xiaolongsya/x3-stm32-robot-dog/旭日X3 40pin引脚表.png

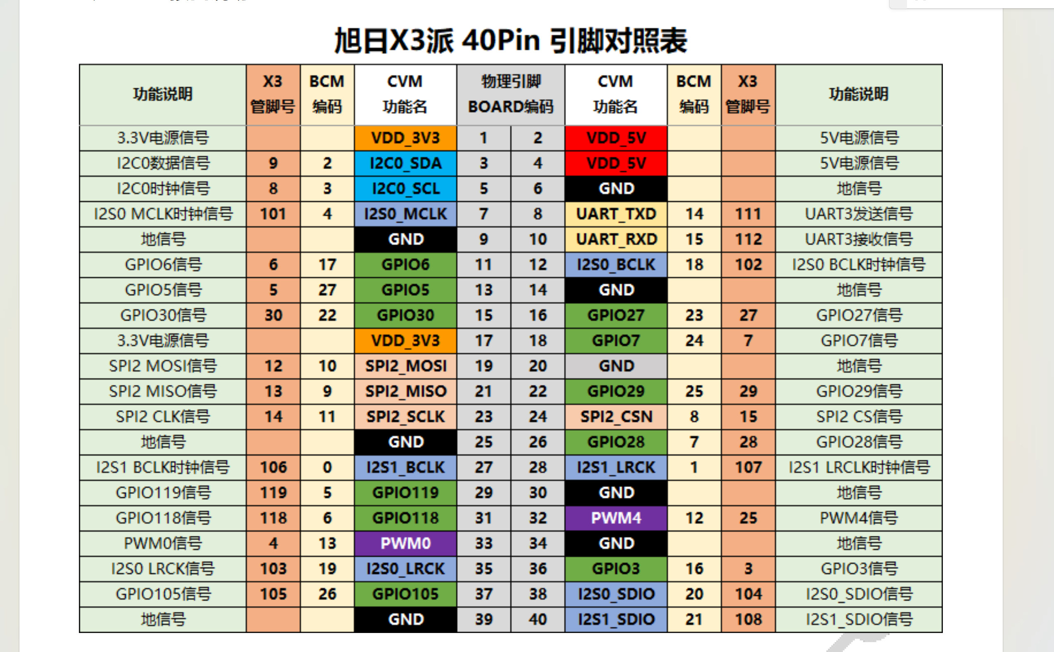
旭日X3 40pin引脚表.png
