xiaolongsya/x3-stm32-robot-dog/BOM采购清单_对照库存.md

# 机器狗 v1 BOM 采购清单(对照元器件库存)

> **生成日期**:2026-09-02 22:30
> **对照基准**:`c:/Users/17402/Desktop/元器件库存.md`(2026-08-24)
> **说明**:对照后逐行核对,有库存 = ✓,无库存 = ✗,有但封装/型号不匹配 = ⚠️
>
> **采购优先级**:
> - ✗ 必须买(库存没有,机器狗 v1 PCB 需要)
> - ⚠️ 建议买(库存有但封装/型号不匹配,勉强可代)
> - ✓ 不用买(库存有同型号,直接用)

---

## 一、电阻

| # | Designator | 值 | 封装 | 库存? | 备注 |
|---|---|---|---|---|---|
| 1 | R1 | 10kΩ | 0603 | ✓ | 库存 FRC0603J103 ×100 |
| 2 | R2 | 10kΩ | 0603 | ✓ | 同上 |
| 3 | R3 | 1kΩ | 0603 | ✓ | 库存 FRC0603F1001TS ×100 |
| 4 | R5 | 1kΩ | 0603 | ✓ | 同上 |
| 5 | R10 | 4.7kΩ | 0603 | ✓ | 库存 FRC0603F4701TS ×100(C1 修复后改 4.7kΩ) |
| 6 | R11 | 4.7kΩ | 0603 | ✓ | 同上 |
| 7 | R13 | 10kΩ | 0805 | ✓ | 库存 FRC0805F1002TS ×100 |
| 8 | R15 | 200kΩ | 0603 | ✗ | **库存没有**,必须新买(C2907009) |
| 9 | R16 | 100kΩ | 0603 | ✓ | 库存 FRC0603F1003TS ×100 |

---

## 二、电容

| # | Designator | 值 | 耐压 | 封装 | 库存? | 备注 |
|---|---|---|---|---|---|---|
| 10 | C1 | 100nF | 50V | C0603 | ✓ | 库存 FCC0603B104K500CT ×50 |
| 11 | C2 | 100nF | 50V | C0603 | ✓ | 同上 |
| 12 | C3 | 22µF(陶瓷)| 16V | C0603 | ⚠️ | **库存只有 0805 22µF,封装不匹配,建议买 0603** |
| 13 | C4 | 22µF(陶瓷)| 16V | C0603 | ⚠️ | 同上 |
| 14 | C6 | 100nF | 50V | C0603 | ✓ | 同 C1 |
| 15 | C7 | 100nF | 50V | C0603 | ✓ | 同 C1 |
| 16 | C9 | 100nF | 50V | C0603 | ✓ | 同 C1 |
| 17 | C10 | 22µF(铝电解)| 16V | SMD 4×4.3 | ✓ | 库存 JVJ16V22M4X5 ×20 |
| 18 | C11 | 100nF | 50V | C0603 | ✓ | 同 C1 |
| 19 | C12 | 100nF | 50V | C0603 | ✓ | 同 C1 |
| 20 | C13 | 10nF | 50V | C0603 | ✗ | **库存没有**,必须新买(C5137477) |
| 21 | C14 | 100nF | 50V | C0603 | ✓ | 同 C1 |
| 22 | C15 | 100nF | 50V | C0603 | ✓ | 同 C1 |
| 23 | C16 | 100nF | 50V | C0603 | ✓ | 同 C1 |
| 24 | C18 | 100nF | 50V | C0603 | ✓ | 同 C1 |
| 25 | C19 | 470µF(铝电解)| 35V | SMD 10×10.3 | ⚠️ | **库存只有 12.5×13.6 470µF,尺寸略大**,建议买 10×10 |
| 26 | C20 | 220µF(铝电解)| 25V | SMD 6.3×6.6 | ⚠️ | **库存只有 10×10.3 220µF,尺寸偏大**,建议买 6.3×6.6 |
| 27 | C21 | 220µF(铝电解)| 25V | SMD 6.3×6.6 | ⚠️ | 同 C20 |
| 28 | C22 | 22pF | 50V | C0603 | ✗ | **库存没有 22pF 0603**(只有 0402 100pF),必须新买(C1653) |
| 29 | C23 | 22pF | 50V | C0603 | ✗ | 同上 |

---

## 三、二极管 / 保险丝

| # | Designator | 型号 | 封装 | 库存? | 备注 |
|---|---|---|---|---|---|
| 30 | D1 | SS54(5A/40V 肖特基)| SMA 贴片 | ⚠️ | **库存只有 1N5825 DO-201AD(插件),封装不同,不可代,必买 SS54** |
| 31 | D2 | SS54(5A/40V 肖特基)| SMA 贴片 | ⚠️ | 同上 |
| 32 | F1 | SMD2920-500-24(5A/24V 自恢复)| F2920 | ✓ | 库存 R+O C47753903 ×5 |

---

## 四、电感

| # | Designator | 值 | 封装 | 库存? | 备注 |
|---|---|---|---|---|---|
| 33 | L1 | 33µH ≥5A Isat | GSM1040(11.5×10.5)| ✓ | 库存 FAUKU GSM1040-330-M ×5 |
| 34 | L2 | 33µH ≥5A Isat | GSM1040(11.5×10.5)| ✓ | 同上 |

---

## 五、IC(芯片)

| # | Designator | 型号 | 封装 | 库存? | 备注 |
|---|---|---|---|---|---|
| 35 | U1 | STM32G431KBT6TR | LQFP-32(7×7)| ✗ | **库存没有 STM32G431 系列,必须新买**(C5270317,¥15) |
| 36 | U2 | LM2596S-5.0(固定 5V 版)| TO-263-5 | ⚠️ | **库存只有 1 个 LM2596S-5.0,机器狗需要 2 个,再买 1 个**(C2980820) |
| 37 | U10 | LM2596S-5.0(固定 5V 版)| TO-263-5 | ⚠️ | 同上(库存 1 个用完,需再买 1 个) |
| 38 | U9 | AMS1117-3.3(固定 3.3V 版)| SOT-223-4 | ✗ | **库存没有 AMS1117,必须新买**(C369933) |

---

## 六、晶体 / 振荡器

| # | Designator | 型号 | 封装 | 库存? | 备注 |
|---|---|---|---|---|---|
| 39 | X1 | 8MHz 贴片 | SMD 3225(3.2×2.5)| ✗ | **库存没有贴片晶振,必须新买**(YXC X32258MSB4SI, C2682774) |

---

## 七、晶体管 / 三极管

| # | Designator | 型号 | 封装 | 库存? | 备注 |
|---|---|---|---|---|---|
| 40 | Q1 | SS8050(NPN, β≥100, Vceo=25V)| SOT-23-3 | ✗ | **库存没有 SS8050**(只有 AO3401A P-MOS),必须新买(C7420370) |

---

## 八、LED

| # | Designator | 型号 | 封装 | 库存? | 备注 |
|---|---|---|---|---|---|
| 41 | LED1 | GL0805UR01(红)| 0805 | ✓ | 库存 XL-2012SURC 0805 红 LED ×100(可代,亮度可能略低) |

---

## 九、按键 / 开关

| # | Designator | 型号 | 封装 | 库存? | 备注 |
|---|---|---|---|---|---|
| 42 | KEY1 | TS-1045AD-A8B3-D2 | SMD 4-pin | ✗ | **库存没有触摸开关,必须新买**(C2894745,LCSC 标 YUANDI) |
| 43 | RESET1 | TS-1045AD-A8B3-D2 | SMD 4-pin | ✗ | 同上 |
| 44 | SW1 | HX KCD11-2P-R(船型开关)| THT | ✗ | **库存没有船型开关,必须新买**(C6917318) |

---

## 十、蜂鸣器

| # | Designator | 型号 | 封装 | 库存? | 备注 |
|---|---|---|---|---|---|
| 45 | BUZZER1 | ~~2.7kHz 电磁蜂鸣器~~ | BUZ-TH_BD9.0 | ✗ (~~不装~~) | **2026-09-16 链路作废,不采购**(原:C96256,QMB-09B-03) |

---

## 十一、连接器 / 排针

| # | Designator | 型号 | 封装 | 库存? | 备注 |
|---|---|---|---|---|---|
| 46 | CN1 | XT30PW-M 母座(电池)| THT | ✗ | **库存没有 XT30,必须新买**(C431092,AMASS) |
| 47 | Pi | HX 2.54mm-2P ZZ-MS(XH2.54 2P 母座)| THT | ✓ | 库存 XH2.54 2P 母座 |
| 48 | HC-SR04 | LAIL-PHC2.54-4P-01-XH-L | THT 4P | ✓ | 库存 XH2.54 4P 母座 ×20 |
| 49 | OLED | LAIL-PHC2.54-4P-01-XH-L | THT 4P | ✓ | 同上 |
| 50 | H5 | 01.5.5.1.304.03(12P 排针)| HDR-TH_12P-2.54 | ⚠️ | 库存有 2.54 通用排针,可代用(剪 12P) |
| 51 | H6 | 01.5.5.1.304.03(12P 排针)| HDR-TH_12P-2.54 | ⚠️ | 同上 |
| 52 | J1 | 2.54-1×10P 直立排针 | HDR-TH_10P-2.54 | ✓ | 库存 BOOMELE 1×10P |
| 53 | J2 | 2.54-1×10P 直立排针 | HDR-TH_10P-2.54 | ✓ | 同上 |
| 54 | MPU6050 | 2.54-1×8 直立排针 | HDR-TH_8P-2.54 | ⚠️ | 库存有 2.54 通用排针,可代用(剪 8P) |

---

## 十二、测试点

| # | Designator | 型号 | 封装 | 库存? | 备注 |
|---|---|---|---|---|---|
| 55 | TP1 | Test-Point | Test-Point-0.5mm | ✗ | **库存没有测试点,必须新买** |
| 56 | TP2 | Test-Point | Test-Point-0.5mm | ✗ | 同上 |

---

## 十三、外部模块(非 PCB 板载元件)

| # | 模块 | 库存? | 备注 |
|---|---|---|---|
| 57 | MPU6050 GY-521 模块 | ✗ | 淘宝/嘉立创 ~¥5 |
| 58 | SSD1306 OLED 0.96" I2C | ✗ | 淘宝 ~¥5 |
| 59 | HC-SR04 超声波测距(新版免分压) | ✗ | 淘宝 ~¥3 |
| 60 | MG90S 舵机 ×8 | ✗ | 淘宝 ~¥10×8 = ¥80(大头) |
| 61 | 香橙派 Zero3 | ✗ | 淘宝 ~¥100 |
| 62 | 2S 18650 6800mAh 电池组(蓝火新能源)| ✗ | 淘宝 ~¥80 |

---

## 十四、机械件

| # | Designator | 型号 | 库存? | 备注 |
|---|---|---|---|---|
| 63 | M1 | M3 螺丝孔 | ✓ | 库存 M3×5/×10 |
| 64 | M2 | M3 螺丝孔 | ✓ | 同上 |
| 65 | M3 | M3 螺丝孔 | ✓ | 同上 |
| 66 | M4 | M3 螺丝孔 | ✓ | 同上 |

---

## 📊 汇总统计

| 类别 | 数量 |
|---|---|
| ✓ 库存有,直接用 | **20 项** |
| ⚠️ 库存有但需新买(封装/型号不匹配) | **9 项** |
| ✗ 库存没有,必须新买 | **19 项** |
| **总计元件位** | **48 项**(PCB 板载,不含外部模块/电池) |

---

## 🛒 必须新买的清单(19 项,按优先级)

### IC(核心,¥22)
- ✗ **U1 STM32G431KBT6TR ×1** ¥15 (C5270317)
- ⚠️ **U2/U10 LM2596S-5.0 ×2** ¥3 ×2 = ¥6 (C2980820)— 库存有 1 个,再买 1 个
- ✗ **U9 AMS1117-3.3 ×1** ¥0.5 (C369933)

### 元件(¥6)
- ✗ R15 200kΩ 0603 ×1 ¥0.05 (C2907009)
- ✗ C13 10nF 0603 ×1 ¥0.05 (C5137477)
- ✗ C22 C23 22pF 0603 ×2 ¥0.1 (C1653)
- ✗ Q1 SS8050 ×1 ¥0.3 (C7420370)
- ✗ X1 8MHz 3225 ×1 ¥1 (C2682774)
- ⚠️ D1/D2 SS54 SMA ×2 ¥1 ×2 = ¥2 (C7420369)— 库存 1N5825 DO-201AD 不可代
- ⚠️ C3/C4 22µF 0603 ×2 ¥0.5 — 库存 0805 不能代
- ⚠️ C19 470µF 10×10 ×1 ¥2 — 库存 12.5×13.6 略大
- ⚠️ C20/C21 220µF 6.3×6.6 ×2 ¥1 — 库存 10×10.3 偏大

### 接口 / 开关 / 蜂鸣器(¥8)
- ✗ CN1 XT30PW-M ×1 ¥2 (C431092)
- ✗ SW1 KCD11-2P-R ×1 ¥2 (C6917318)
- ✗ KEY1/RESET1 TS-1045AD ×2 ¥0.5×2 = ¥1 (C2894745)
- ~~✗ BUZZER1 2.7kHz ×1 ¥1.5 (C96256)~~ — **2026-09-16 作废,不采购**
- ✗ TP1/TP2 ×2 ¥0.5

### 板外大件(¥268,大头)
- ✗ MG90S ×8 ¥80
- ✗ Pi Zero3 ×1 ¥100
- ✗ 2S 18650 电池 ×1 ¥80
- ✗ MPU6050 模块 ×1 ¥5
- ✗ SSD1306 OLED ×1 ¥5
- ✗ HC-SR04 ×1 ¥3

---

## 💰 总预算估算

| 类别 | 估算金额 |
|---|---|
| PCB 板载元件必须新买 | **~¥36** |
| PCB 板载元件建议补买 | **~¥6** |
| 板外模块(舵机/Pi/电池)| **~¥273** |
| **总计** | **~¥315** |

(对比 README 估的 ¥127,**板载元件实际采购可省 ¥91**,但加上 Pi/电池/舵机,实际总成本约 ¥315)

---

## ✅ 不需新买(全部用库存,共 20 项)

| 类别 | 数量 |
|---|---|
| 电阻 R1/R2/R3/R5/R10/R11/R13/R16 | 9 颗 |
| 电容 C1/C2/C6/C7/C9/C10/C11/C12/C14/C15/C16/C18 | 12 颗(都是 100nF 0603 或 22µF SMD) |
| 自恢复保险丝 F1 | 1 |
| 电感 L1/L2 | 2 |
| LED LED1 | 1 |
| Pi 排针/HC-SR04/OLED 母座/J1/J2 | 5 |
| 螺丝 M1-M4 | 4 |

---

**生成完毕,对比你的实际库存,在 ✗ 处标"已有"/"要买"。**
