xiaolongsya/x3-stm32-robot-dog/RDK_X3_2.0_IO_Schematics.pdf

# RDK X3 2.0 40P UART Debug

### J29采用立式插针

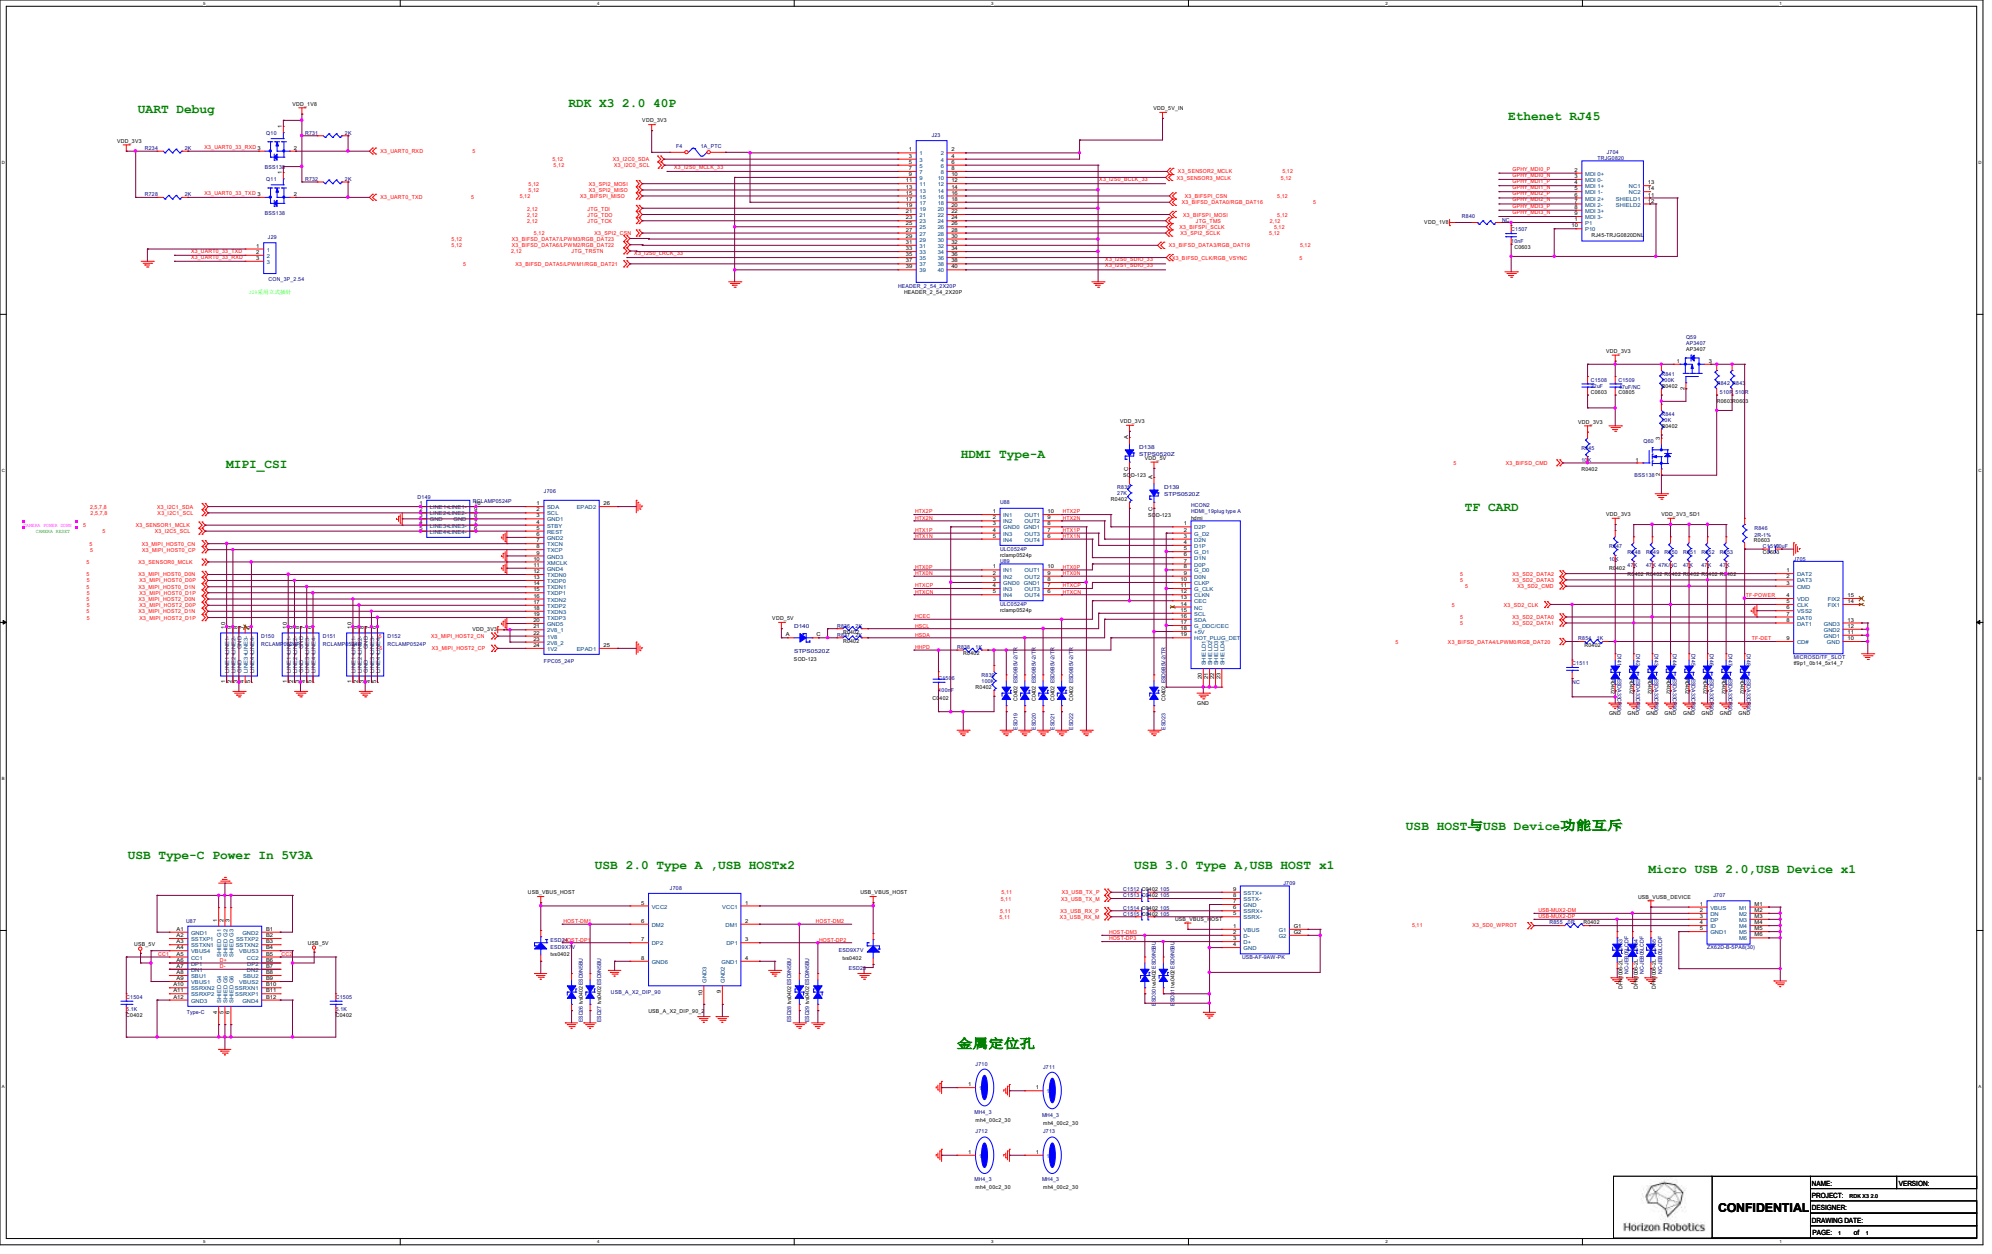
[picture p2: page 1]

R0402 | R0402 | R0402 | R0402 | R0402 | R0402 | DAT3 2

CLK 5 VSS2 6

USB Type-C Power In 5V3A
