xiaolongsya/x3-stm32-robot-dog/STM32项目/MachineDog_V1/Core/Src/main.c

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
/* Includes ------------------------------------------------------------------*/
#include "main.h"
#include "dma.h"
#include "i2c.h"
#include "tim.h"
#include "usart.h"
#include "gpio.h"

/* USER CODE BEGIN Includes */
#include <stdio.h>
#include <string.h>
#include "stepping.h"
#include "motions.h"
#include "commands.h"   /* 2026-09-14 X3 协议入口 */
#include "watchdog.h"   /* 2026-09-14 心跳超时守护 */
#include "diagnostic.h" /* 2026-09-16 上电诊断标记 (从 main.c 搬出, 见 diagnostic.c) */
#include "ramp.h"       /* 2026-09-16 SIT/STAND 渐进 ramp, motion_poll() 自动调 ramp_tick() */
/* USER CODE END Includes */


/* USER CODE BEGIN PV */
/* 8 路舵机 STAND PWM 常量在 main.h(SERVO_*_STAND)
 * 2026-09-11 废弃 gait.c 后,STAND 不再运行时覆盖,改用常量直读
 */
/* USER CODE END PV */

void SystemClock_Config(void);
/* USER CODE BEGIN 0 */
/* 8 路舵机映射表 (servo_id 0-7):
 *  0=PA2=TIM15_CH1=servo0  4=PA6=TIM3_CH1=servo4
 *  1=PA3=TIM15_CH2=servo1  5=PA7=TIM17_CH1=servo5
 *  2=PA4=TIM3_CH2=servo2   6=PB0=TIM3_CH3=servo6
 *  3=PA5=TIM2_CH1=servo3   7=PA8=TIM1_CH1=servo7
 *
 * 腿分布(2026-09-10 用户确认,对称):
 *  前肩: servo3(FR), servo4(FL)
 *  前小腿: servo2(FR), servo5(FL)
 *  后肩: servo1(BR), servo6(BL)
 *  后小腿: servo0(BR), servo7(BL)
 */

/* 当前 8 路舵机 PWM(2026-09-11 移除,cal save 废弃后不需要跟踪) */

/* 非 static:供未来 stepping 模块调用(原型在 main.h)
 * 2026-09-11 移除 current_pwm 跟踪,gait.c 已删,无其他模块需要 */
void set_servo_pulse(uint8_t id, uint16_t pulse) {
  if (pulse < 500 || pulse > 2500) return;
  /* 2026-09-16:同步给 ramp.c 的 g_pwm 跟踪,ramp 起点采样用 */
  motions_track_pwm(id, pulse);
  switch (id) {
    case 0: __HAL_TIM_SET_COMPARE(&htim15, TIM_CHANNEL_1, pulse); break;
    case 1: __HAL_TIM_SET_COMPARE(&htim15, TIM_CHANNEL_2, pulse); break;
    case 2: __HAL_TIM_SET_COMPARE(&htim3, TIM_CHANNEL_2, pulse); break;
    case 3: __HAL_TIM_SET_COMPARE(&htim2, TIM_CHANNEL_1, pulse); break;
    case 4: __HAL_TIM_SET_COMPARE(&htim3, TIM_CHANNEL_1, pulse); break;
    case 5: __HAL_TIM_SET_COMPARE(&htim17, TIM_CHANNEL_1, pulse); break;
    case 6: __HAL_TIM_SET_COMPARE(&htim3, TIM_CHANNEL_3, pulse); break;
    case 7: __HAL_TIM_SET_COMPARE(&htim1, TIM_CHANNEL_1, pulse); break;
  }
}

/* 2026-09-16:蜂鸣器作废(用户拍板),PA11(BUZZER_CTRL 原蜂鸣器驱动脚)
 * 改为输出低,保持静默。硬件(R5 + Q1 SS8050 + D3 + BUZZER1)保留在板上不驱动。
 * 如果未来复用 PA11 为其他 GPIO,可改这里或加新 init。
 */
static void pa11_silent_init(void) {
  __HAL_RCC_GPIOA_CLK_ENABLE();
  GPIO_InitTypeDef gpio = {0};
  gpio.Pin   = GPIO_PIN_11;
  gpio.Mode  = GPIO_MODE_OUTPUT_PP;
  gpio.Pull  = GPIO_NOPULL;
  gpio.Speed = GPIO_SPEED_FREQ_LOW;
  HAL_GPIO_Init(GPIOA, &gpio);
  HAL_GPIO_WritePin(GPIOA, GPIO_PIN_11, GPIO_PIN_RESET);
}

/* 2026-09-14:text 命令解析搬到 commands.c(text 兼容模式),
 * binary 协议也由 commands.c 处理。这里不再有 parse_uart_command / uart_poll。*/
/* USER CODE END 0 */

/**
  * @brief  The application entry point.
  * @retval int
  */
int main(void)
{

  /* MCU Configuration--------------------------------------------------------*/

  /* Reset of all peripherals, Initializes the Flash interface and the Systick. */
  HAL_Init();

  /* Configure the system clock */
  SystemClock_Config();

  /* Initialize all configured peripherals */
  MX_GPIO_Init();
  MX_DMA_Init();
  MX_I2C1_Init();
  MX_TIM2_Init();
  MX_TIM3_Init();
  MX_TIM17_Init();
  MX_USART1_UART_Init();
  MX_TIM15_Init();
  MX_TIM6_Init();
  MX_TIM7_Init();
  MX_TIM1_Init();
  /* USER CODE BEGIN 2 */
  /* ⚠️ 2026-09-12 no-reply 修复:禁用 stdout 缓冲
   * 否则 newlib 可能把 printf 输出缓存在 FILE 里,直到 \n 才 flush,
   * 期间如果进程卡死,数据全丢 */
  setvbuf(stdout, NULL, _IONBF, 0);

  /* 2026-09-16 重构:诊断字符搬到 diagnostic.c(避免 CubeMX Generate Code 丢 })*/


  /* === 2026-09-15 BOOT 标识(诊断 STM32 ↔ X3 链路)===
   * X3 端跑 listen_booted.py 监听 ttyS3,收到 BOOT 说明:
   *   - STM32 跑到了 main()
   *   - USART1 TX 通路正常(PA9 输出)
   * 8 路被强制设"标准值"(跪下姿态,含 FL 肩 +100 / BL 小腿 +80 物理偏移)
   *   = 证明 PWM 输出也正常
   * (2026-09-16:删掉'蜂鸣器响 = 跑到这里'那行,蜂鸣器链路作废)
   */
  /* ⚠️ CubeMX 不自动调 HAL_TIM_PWM_MspPostInit -> 必须手动启动 HAL_TIM_PWM_Start
   * 注意:set_servo_pulse 必须在 HAL_TIM_PWM_Start 之后 */
  HAL_TIM_PWM_Start(&htim1, TIM_CHANNEL_1);    /* PA8  = TIM1_CH1 = servo7 */
  HAL_TIM_PWM_Start(&htim2, TIM_CHANNEL_1);    /* PA5  = TIM2_CH1 = servo3 */
  HAL_TIM_PWM_Start(&htim15, TIM_CHANNEL_1);   /* PA2  = TIM15_CH1 = servo0 */
  HAL_TIM_PWM_Start(&htim15, TIM_CHANNEL_2);   /* PA3  = TIM15_CH2 = servo1 */
  HAL_TIM_PWM_Start(&htim3, TIM_CHANNEL_1);    /* PA6  = TIM3_CH1 = servo4 */
  HAL_TIM_PWM_Start(&htim3, TIM_CHANNEL_2);    /* PA4  = TIM3_CH2 = servo2 */
  HAL_TIM_PWM_Start(&htim3, TIM_CHANNEL_3);    /* PB0  = TIM3_CH3 = servo6 */
  HAL_TIM_PWM_Start(&htim17, TIM_CHANNEL_1);   /* PA7  = TIM17_CH1 = servo5 */

  /* === 上电默认姿态(2026-09-14 整理)===
   * 1) stepping_init() 初始化步态状态机(暂不启 TIM6,等 motion 触发)
   * 2) motion_init() 装载 MOTION_ID + 启动对应动作:
   *    - 先写 8 路 = 标准值/跪下(motion_apply_neutral,含物理偏移)作为安全起点
   *    - 调 current->setup() 跳到对应姿态(STAND / TROT_STAND / SIT)
   *
   * 默认动作(motions.h 的 MOTION_ID = MOTION_STAND):
   *    - 上电跳 STAND 后保持不动,等 X3 命令
   *    - 改 MOTION_ID = MOTION_TROT 才会自动踏步(5s 后启动,30s 结束)
   *
   * 切换其他模式:改 motions.h 的 MOTION_ID
   *    MOTION_STAND    :上电跳 STAND 后保持
   *    MOTION_BOB      :上电跳 STAND,5s 后蹲下,5s 后回 STAND,循环
   *    MOTION_SHIN_TEST:8 路同步线性 ramp 测小腿范围
   */
  stepping_init();
  motion_init();
  /* 2026-09-14:X3 协议 + 心跳守护 */
  commands_init();   /* USART1 DMA + IDLE 启动 */
  watchdog_init();   /* TIM7 1kHz 启动,X3 不发命令 200ms 后自动 STAND */

  /* 上电诊断标记(发 '1' '2' '3' '5' '6' 'B',tabby 看到 = STM32 跑到这步) */
  diagnostic_init();
  /* 2026-09-16:蜂鸣器作废,PA11(BUZZER_CTRL) 输出低保持静默(原 buzzer_init() 替换) */
  pa11_silent_init();
  /* USER CODE END 2 */

  /* Infinite loop */
  /* USER CODE BEGIN WHILE */
  diagnostic_mainloop();  /* 发 'C' = 进 main loop */
  while (1)
  {
    /* USER CODE END WHILE */

    /* USER CODE BEGIN 3 */
    /* === 主循环(2026-09-14:X3 上线后)===
     * 1) motion_poll():推进动作状态机
     * 2) commands_poll():解析 USART1 DMA + IDLE 收到的二进制 / 文本帧
     * 注:watchdog 由 TIM7 1kHz ISR 驱动,不需要在主循环调
     */
    motion_poll();
    commands_poll();
  /* USER CODE END 3 */
  }
}

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
