xiaolongsya/x3-stm32-robot-dog/STM32项目/MachineDog_V1/Core/Inc/main.h

#define SERVO_SHOULDER_FL_STAND   2000  /* 左前肩:PA6/TIM3_CH1/servo4  ↑身体高 / ↓身体低 */
#define SERVO_SHIN_FL_STAND       1400  /* 左前小腿:PA7/TIM17_CH1/servo5 ↑身体高 / ↓身体低 */
#define SERVO_SHOULDER_FR_STAND   1100  /* 右前肩:PA5/TIM2_CH1/servo3  ↑身体高 / ↓身体低 */
#define SERVO_SHIN_FR_STAND       1600  /* 右前小腿:PA4/TIM3_CH2/servo2 ↑身体高 / ↓身体低 */
#define SERVO_SHOULDER_BL_STAND   1900  /* 左后肩:PB0/TIM3_CH3/servo6  ↑身体高 / ↓身体低 */
#define SERVO_SHIN_BL_STAND       1480  /* 左后小腿:PA8/TIM1_CH1/servo7 ↑身体高 / ↓身体低 */
#define SERVO_SHOULDER_BR_STAND   1100  /* 右后肩:PA3/TIM15_CH2/servo1  ↑身体高 / ↓身体低 */
#define SERVO_SHIN_BR_STAND       1600  /* 右后小腿:PA2/TIM15_CH1/servo0 ↑身体高 / ↓身体低 */
#define SERVO_NEUTRAL_US           1500
#define SERVO_OFFSET_FL_SHOULDER   100
#define SERVO_OFFSET_BL_SHIN        80
#define SERVO_NEUTRAL_FL_SHOULDER  (SERVO_NEUTRAL_US + SERVO_OFFSET_FL_SHOULDER)  /* 1600 */
#define SERVO_NEUTRAL_BL_SHIN      (SERVO_NEUTRAL_US + SERVO_OFFSET_BL_SHIN)      /* 1580 */
