xiaolongsya/x3-stm32-robot-dog/X3端/kws/kws_record_send.py

#!/usr/bin/env python3
"""kws_record_send.py — X3 端 KWS 唤醒 → VAD 录音 → WS 上传 PC brain → STM32 执行

⚠️ 2026-09-16 DEPRECATED: 单进程架构存在 oww stateful buffer 二次唤醒根因
   (commit 84ec2ac + 8fd5d1c 打补丁只是治标)。
   已替换为双进程架构: kws_listener.py + kws_worker.py + start_kws_dual.sh
   本文件保留作 fallback,不删除;新部署请用 start_kws_dual.sh。

2026-09-16:生产链路打通版本。

链路:
    arecord (16k mono S16_LE)
       ↓
    KWS 推理 (xiaolong.onnx, 80ms 一段)
       ↓ 唤醒(score > threshold)
    VAD 录音 (累计静音 1.5s 或最大 8s)
       ↓
    base64 PCM → WS 长连 PC brain (ws://<本机IP>:8765)
       ↓
    等 {type: action, actions: [...]} 响应
       ↓
    翻译成 STM32 UART 帧 + 发 /dev/ttyS3@115200

后台:
- STM32 心跳 100ms 一发(防 watchdog 200ms 超时回 STAND)
- WS 断线指数退避 1s/2s/4s/8s/最大 8s

用法:
    /root/kws/kws_record_send.py --pc-url  ws://192.168.160.91:8765

依赖:openwakeword / onnxruntime / pyserial / websockets / numpy
"""
import argparse
import asyncio
import base64
import json
import os
import struct
import sys
import threading
import time

import numpy as np
import serial

DEFAULT_MODEL  = "/root/kws/xiaolong.onnx"
DEFAULT_PORT   = "/dev/ttyS3"
DEFAULT_BAUD   = 115200
DEFAULT_PC_URL = "ws://192.168.160.91:8765"
DEFAULT_THRESH = 0.85
CHUNK = 1280           # 80ms @ 16kHz
MAX_SILENCE_CHUNKS = 18    # 80ms × 18 = 1.44s 静音
MAX_RECORD_CHUNKS  = 100   # 80ms × 100 = 8s 最大


def csum8(data: bytes) -> int:
    c = 0
    for b in data:
        c ^= b
    return c & 0xFF


def send_frame(ser: serial.Serial, cmd: int, payload: bytes = b"") -> None:
    body = bytes([len(payload), cmd]) + payload
    ser.write(b"\xaa\x55" + body + bytes([csum8(body)]))
    ser.flush()


def action_to_stm32_frame(action: dict) -> bytes | None:
    """LLM 输出 action → STM32 UART 帧"""
    cmd_name = action.get("cmd")
    if cmd_name == "ACTION_PLAY":
        action_id = action.get("id")
        if action_id not in (5, 6, 7, 8):
            return None
        return send_frame_bytes(0x09, bytes([action_id, 1]))
    elif cmd_name == "MOTION_PLAY":
        motion_id = action.get("id")
        dur_ms = int(action.get("duration_ms", 5000))
        if motion_id not in (1, 2, 3, 4):
            return None
        payload = bytes([motion_id]) + struct.pack("<I", dur_ms)
        return send_frame_bytes(0x01, payload)
    elif cmd_name == "EMERGENCY_STOP":
        return send_frame_bytes(0x06, b"")
    return None


def send_frame_bytes(cmd: int, payload: bytes) -> bytes:
    body = bytes([len(payload), cmd]) + payload
    return b"\xaa\x55" + body + bytes([csum8(body)])


def compute_rms(pcm_bytes: bytes) -> int:
    """计算帧 RMS,用于静音检测"""
    samples = np.frombuffer(pcm_bytes, dtype=np.int16)
    if len(samples) == 0:
        return 0
    return int(np.sqrt(np.mean(samples.astype(float) ** 2)))


SILENCE_RMS_THRESHOLD = 500   # 帧 RMS < 500 视为静音(VAD 终止条件)
RMS_KWS_LOW = 100               # KWS 评分前 RMS 下限(< 此值 = 没人说话,跳过)
RMS_KWS_HIGH = 3500             # KWS 评分前 RMS 上限(> 此值 = 狗机械声/拍桌/噪声,跳过)


class X3KWSBrainLink:
    """X3 端:KWS + VAD 录音 + WS 上传 + STM32 翻译"""

    # 状态机:
    # "kws"       - KWS 评分监听中
    # "recording" - VAD 录音中(刚唤醒)
    # "busy"      - WS 上传 + STM32 执行中(屏蔽 KWS,防止回声触发)
    # cooldown 默认 10s(KWS 唤醒冷却,防回声短窗触发)

    def __init__(self, model_path, port, baud, pc_url, threshold, cooldown):
        self.threshold = threshold
        self.cooldown = cooldown
        self.pc_url = pc_url
        self.last_wake_ts = 0.0
        self.mode = "kws"

        # STM32 串口
        self.ser = serial.Serial(port, baud, timeout=0.5)
        # 心跳守护
        self.hb_stop = threading.Event()
        threading.Thread(target=self._heartbeat, daemon=True).start()

        # KWS 模型
        from openwakeword.model import Model
        self.oww = Model(wakeword_models=[model_path], inference_framework="onnx")
        print(f"[kws] 模型: {model_path}, 阈值: {threshold}")

        # 状态
        self.mode = "kws"            # "kws" / "recording"
        self.record_buffer = []       # 录音缓冲(list of bytes)
        self.silence_chunks = 0

    def _heartbeat(self):
        while not self.hb_stop.is_set():
            send_frame(self.ser, 0x05)
            self.hb_stop.wait(0.1)

    def process_chunk(self, chunk: bytes) -> bytes | None:
        """处理一帧 80ms PCM。返回非 None 表示录音完成。"""
        # busy 状态:录音 + WS + STM32 期间完全不评分
        if self.mode == "busy":
            return None

        if self.mode == "kws":
            # 唤醒冷却:距离上次唤醒 < cooldown,不评分
            now = time.time()
            if now - self.last_wake_ts < self.cooldown:
                return None
            # RMS 预筛:狗机械声 RMS 很高(>3500),人说话 RMS 中等(100-3500)
            # 跳过纯静音(<100)和疑似机械噪声(>3500),只让中间区间评分
            rms = compute_rms(chunk)
            if rms < RMS_KWS_LOW or rms > RMS_KWS_HIGH:
                return None
            pcm = np.frombuffer(chunk, dtype=np.int16)
            preds = self.oww.predict(pcm)
            if not preds:
                return None
            key = next(iter(preds.keys()))
            s = preds[key]
            try:
                score = float(s[-1] if isinstance(s, (np.ndarray, list)) else s)
            except (TypeError, IndexError):
                return None
            if score >= self.threshold:
                print(f"[kws] 🌟 唤醒 score={score:.3f} rms={rms} → 开始录音")
                self.mode = "recording"
                self.record_buffer = [chunk]
                self.silence_chunks = 0
                self.last_wake_ts = now
            return None
        else:
            # recording 模式
            self.record_buffer.append(chunk)
            rms = compute_rms(chunk)
            if rms < SILENCE_RMS_THRESHOLD:
                self.silence_chunks += 1
            else:
                self.silence_chunks = 0
            if self.silence_chunks >= MAX_SILENCE_CHUNKS:
                pcm = self._finish_recording()
                return pcm
            if len(self.record_buffer) >= MAX_RECORD_CHUNKS:
                pcm = self._finish_recording()
                return pcm
            return None

    def set_busy(self, busy: bool):
        """录音完成 → WS 上传 → STM32 执行期间设为 busy,屏蔽 KWS"""
        self.mode = "busy" if busy else "kws"
        if busy:
            self.last_wake_ts = time.time()  # busy 期内也算冷却起点
        print(f"[kws] 模式: {self.mode}")

    def _finish_recording(self):
        pcm = b"".join(self.record_buffer)
        print(f"[rec] 录音完成 {len(pcm)} bytes ({len(pcm)/32000:.2f}s)")
        self.record_buffer = []
        # 关键:这里设 "busy" 而不是 "kws",防止主循环拿到 pcm 之前的窗口期
        # KWS 误判录音期间的 chunk(set_busy 在主循环里调用,有 race condition)
        self.mode = "busy"
        self.silence_chunks = 0
        return pcm

    async def send_to_brain(self, pcm: bytes) -> dict | None:
        """WS 上传 PC brain,等 action 响应。返回 actions 列表或 None"""
        import websockets
        ws_id = "x3_local"
        try:
            async with websockets.connect(self.pc_url) as ws:
                print(f"[ws] 已连接 {self.pc_url}")
                # 发 utterance
                await ws.send(json.dumps({
                    "type": "utterance",
                    "pcm": base64.b64encode(pcm).decode(),
                    "session_id": ws_id,
                }))
                print(f"[ws] → utterance ({len(pcm)} bytes)")
                # 等响应(可能 action 或 error)
                while True:
                    raw = await ws.recv()
                    msg = json.loads(raw)
                    print(f"[ws] ← {msg}")
                    if msg["type"] in ("action", "error"):
                        return msg
        except Exception as e:
            print(f"[ws] 错误: {e}")
            return None

    def translate_and_send_actions(self, actions: list):
        """翻译 actions 为 STM32 帧并发送"""
        for a in actions:
            frame = action_to_stm32_frame(a)
            if frame:
                self.ser.write(frame)
                self.ser.flush()
                print(f"[stm32] → {a['cmd']} #{a.get('id','')}"
                      + (f" dur={a.get('duration_ms')}ms" if 'duration_ms' in a else ""))
            else:
                print(f"[stm32] 跳过非法: {a}")

    def close(self):
        self.hb_stop.set()
        self.ser.close()


async def websockets_connect(url):
    import websockets
    return websockets.connect(url)


async def stdin_reader(queue: asyncio.Queue):
    """后台线程:读 arecord stdin(80ms 一段)→ 放入 asyncio.Queue"""
    loop = asyncio.get_event_loop()

    def _read():
        while True:
            chunk = sys.stdin.buffer.read(CHUNK * 2)
            if not chunk:
                break
            asyncio.run_coroutine_threadsafe(queue.put(chunk), loop)
    t = threading.Thread(target=_read, daemon=True)
    t.start()


async def run(args):
    link = X3KWSBrainLink(
        model_path=args.model,
        port=args.port,
        baud=args.baud,
        pc_url=args.pc_url,
        threshold=args.threshold,
        cooldown=args.cooldown,
    )

    queue: asyncio.Queue = asyncio.Queue()
    await stdin_reader(queue)

    print(f"[kws] 启动,PC brain @ {args.pc_url}")
    print(f"[kws] 唤醒冷却 {args.cooldown}s(冷却期内不评分,避免回声触发)")
    print("[kws] 监听中 —— 说 '小龙' 触发整句录音 → WS 上传 → STM32 执行")
    print("=" * 70, flush=True)

    try:
        while True:
            chunk = await queue.get()
            pcm = await asyncio.to_thread(link.process_chunk, chunk)
            if pcm:
                # 录音完毕 → busy 状态(屏蔽 KWS,防回声)
                await asyncio.to_thread(link.set_busy, True)
                # 误唤醒判断:录音时长 < 2s = VAD 静音提前结束 = 没人说话
                # (用户正常说话至少 2-3s,太短说明 KWS 误触发了)
                pcm_duration_s = len(pcm) / 32000
                false_wake = pcm_duration_s < 2.0
                try:
                    resp = await link.send_to_brain(pcm)
                    if resp and resp.get("type") == "action":
                        actions = resp.get("actions", [])
                        reply = resp.get("reply", "")
                        print(f"[brain] reply: {reply}")
                        if actions and not false_wake:
                            # 真有动作 + 录音够长:发 STM32
                            await asyncio.to_thread(link.translate_and_send_actions, actions)
                        elif false_wake:
                            # 录音 < 2s 即便 LLM 给动作也不做(可能是误触发)
                            print(f"[brain] 录音仅 {pcm_duration_s:.2f}s,误唤醒跳过动作")
                        else:
                            # actions=空:用户说了话但能力外,当作正常唤醒
                            print("[brain] actions 空(可能超出能力),不当误唤醒")
                    elif resp and resp.get("type") == "error":
                        print(f"[brain] error: {resp.get('code')} {resp.get('reply')}")
                        if resp.get("code") == "ASR_FAIL":
                            false_wake = True  # ASR 失败 = 录音里没人说话 = 误唤醒
                    else:
                        print("[brain] 无响应")
                finally:
                    # 任务完成后 cooldown 强制 sleep 完整配置值(2026-09-16 修复)
                    # 原版条件 sleep `max(0, cooldown - elapsed)` 会被 ASR 首调 SenseVoiceSmall
                    # + Ollama qwen3:8b 首 token 延迟 8-15s 直接吃掉,remaining 算成 0,无 sleep,
                    # set_busy(False) 立即切回 kws,下一个 chunk 进 oww.predict() 命中旧"小龙"
                    # 残音 → 第二次唤醒(commit 84ec2ac 已加 oww buffer reset,这里补一刀)。
                    # 改成无条件 await asyncio.sleep(args.cooldown) 强制睡满配置值。
                    print(f"[kws] 任务完成,强制 cooldown {args.cooldown:.1f}s")
                    await asyncio.sleep(args.cooldown)
                    # 清空 queue 里累积的"陈旧"chunk(录音期间 + cooldown 期内)
                    # 这些 chunk 可能含 dog 动机械声 / 房间回声
                    # 直接丢弃,从 fresh audio 开始
                    drained = 0
                    while not queue.empty():
                        try:
                            queue.get_nowait()
                            drained += 1
                        except asyncio.QueueEmpty:
                            break
                    if drained > 0:
                        print(f"[kws] 清空 queue {drained} 个陈旧 chunk")
                    # === KWS 二次触发根因修复(2026-09-16)===
                    # oww Model 内部维护 6s sliding audio buffer;录音期间 mode=recording/busy
                    # 完全不喂新数据,buffer 冻在"小龙"音频上,set_busy(False) 后下一帧 predict()
                    # 仍会基于旧"小龙"给高分(score 0.97+),用户实测每次喊一次都触发两次唤醒。
                    # 喂 75 × 80ms = 6s 静音把 oww buffer 整体替换成静音,score 降回 0
                    # (cooldown 检查在 process_chunk 里另有一道防线,这里只负责 reset oww 内部状态)
                    zero_pcm = np.zeros(1280, dtype=np.int16)
                    for _ in range(75):
                        link.oww.predict(zero_pcm)
                    print(f"[kws] oww buffer reset 完成 (喂 6s 静音)")
                    await asyncio.to_thread(link.set_busy, False)
    except KeyboardInterrupt:
        print("\n[kws] Bye")
    finally:
        link.close()


def main():
    ap = argparse.ArgumentParser(description="X3 端 KWS + VAD 录音 + WS 上传 PC brain")
    ap.add_argument("--model",    default=DEFAULT_MODEL)
    ap.add_argument("--port",     default=DEFAULT_PORT)
    ap.add_argument("--baud",     type=int, default=DEFAULT_BAUD)
    ap.add_argument("--pc-url",   default=DEFAULT_PC_URL)
    ap.add_argument("--threshold", type=float, default=DEFAULT_THRESH)
    # cooldown 默认 10s:任务完成后固定冷却,防回声/机械声连环触发
    ap.add_argument("--cooldown",  type=float, default=10.0)
    args = ap.parse_args()

    asyncio.run(run(args))


if __name__ == "__main__":
    main()
