xiaolongsya/x3-stm32-robot-dog/scripts/step_debug.py

#!/usr/bin/env python3
"""step_debug.py — 8 路舵机交互式分步调试,H_LIFT 可调 (2026-09-12)

设计目的:
  step trot 不动,通讯 OK(sit/stand 已验证)。
  分步调试:按腿顺序(左前 → 右前 → 左后 → 右后),每条腿先大腿后小腿。

用法:
  python3 step_debug.py [H_LIFT_MM]

H_LIFT_MM:
  - 命令行参数(默认 10)
  - 也可环境变量 H_LIFT 覆盖
  - 决定所有"收腿"步骤的 PWM 偏移(远场近似 1mm ≈ 4µs)

示例:
  python3 step_debug.py            # 默认 H_LIFT=10mm
  python3 step_debug.py 5          # 5mm(原 commit 753e686 默认)
  python3 step_debug.py 20         # 20mm(FR/FL 小腿临界,余量 20µs)

交互:
  [enter]         执行当前预命令 + 自动跳到下一步
  [数字 n]        跳到第 n 步
  [任意文本]      当作 STM32 命令发送(不跳步,可重复测同一动作)
  [q]            退出(自动回 STAND)

预设步骤按"单腿"递进(用户拍板 2026-09-12):
  - 0~1:   起始 / STAND 确认
  - 2~13:  单腿单关节测试(左前 → 右前 → 左后 → 右后,每条腿:大腿 → 小腿 → 回 STAND)
  - 14~25: 单腿全收测试(同腿顺序)
  - 26~29: step trot 实测(用 STM32 固件里的 H_LIFT)

环境变量:
  KWS_UART   串口设备(默认 /dev/ttyS1)
  KWS_BAUD   波特率(默认 115200)
  H_LIFT     抬腿高度 mm(默认 10,命令行参数覆盖)
"""
import os
import sys
import time
import serial

UART_DEV = os.environ.get("KWS_UART", "/dev/ttyS1")
UART_BAUD = int(os.environ.get("KWS_BAUD", "115200"))
H_LIFT_MM = float(sys.argv[1]) if len(sys.argv) > 1 else float(os.environ.get("H_LIFT", "10"))
PWM_PER_MM = 4.0
DS_PWM = H_LIFT_MM * PWM_PER_MM  # 远场近似 1mm ≈ 4µs

# === 8 路舵机表 (2026-09-12 实测,舵机名用中文) ===
# 腿分布(用户拍板):
#   前腿: 左前 FL (肩=id 4, 小腿=id 5)
#         右前 FR (肩=id 3, 小腿=id 2)
#   后腿: 左后 BL (肩=id 6, 小腿=id 7)
#         右后 BR (肩=id 1, 小腿=id 0)
#
# 收腿 = 身体降低方向:
#   - 右腿 (FR/BR): PWM 减 (前后舵机反向安装)
#   - 左腿 (FL/BL): PWM 增
SERVOS = [
    # (id, 中文名,         STAND, is_right, safe_min, safe_max)
    (0, "右后小腿 (BR)",   1600, True,  1400, 1600),
    (1, "右后肩 (BR)",     1150, True,  1000, 2000),
    (2, "右前小腿 (FR)",   1500, True,  1400, 1600),
    (3, "右前肩 (FR)",     1200, True,  1000, 2000),
    (4, "左前肩 (FL)",     1820, False, 1000, 2000),
    (5, "左前小腿 (FL)",   1500, False, 1400, 1600),
    (6, "左后肩 (BL)",     1850, False, 1000, 2000),
    (7, "左后小腿 (BL)",   1400, False, 1400, 1600),
]


def lift_pwm(id):
    """收腿 PWM(收 H_LIFT*4 µs):右腿 -,左腿 +"""
    s = SERVOS[id]
    return int(s[2] - DS_PWM) if s[3] else int(s[2] + DS_PWM)


def make_steps():
    """根据 H_LIFT 生成步骤列表(按腿顺序:左前 → 右前 → 左后 → 右后)"""
    DS = int(DS_PWM)

    # 各舵机 swing 极值
    LF_sh   = SERVOS[4][2] + DS   # 左前肩 1820+DS
    LF_shin = SERVOS[5][2] + DS   # 左前小腿 1500+DS
    RF_sh   = SERVOS[3][2] - DS   # 右前肩 1200-DS
    RF_shin = SERVOS[2][2] - DS   # 右前小腿 1500-DS
    LB_sh   = SERVOS[6][2] + DS   # 左后肩 1850+DS
    LB_shin = SERVOS[7][2] + DS   # 左后小腿 1400+DS
    RB_sh   = SERVOS[1][2] - DS   # 右后肩 1150-DS
    RB_shin = SERVOS[0][2] - DS   # 右后小腿 1600-DS

    return [
        # 0-1: 起始
        ("0. all 1500 (8 路全中位,确认基本通讯)",          'all 1500',  None),
        ("1. stand (8 路 → STAND 实测 PWM)",               'stand',     None),

        # 2-4: 左前 (FL) — 大腿 → 小腿 → 回 STAND
        (f"2. 左前肩 → {LF_sh} (1820+{DS},左腿收腿方向)",      f'4 {LF_sh}',   None),
        (f"3. 左前小腿 → {LF_shin} (1500+{DS},左腿收腿方向)",    f'5 {LF_shin}', None),
        ("4. 回 STAND (左前测试完)",                       'stand',     None),

        # 5-7: 右前 (FR)
        (f"5. 右前肩 → {RF_sh} (1200-{DS},右腿收腿方向)",      f'3 {RF_sh}',   None),
        (f"6. 右前小腿 → {RF_shin} (1500-{DS},右腿收腿方向)",    f'2 {RF_shin}', None),
        ("7. 回 STAND (右前测试完)",                       'stand',     None),

        # 8-10: 左后 (BL)
        (f"8. 左后肩 → {LB_sh} (1850+{DS},左腿收腿方向)",      f'6 {LB_sh}',   None),
        (f"9. 左后小腿 → {LB_shin} (1400+{DS},左腿收腿方向)",    f'7 {LB_shin}', None),
        ("10. 回 STAND (左后测试完)",                      'stand',     None),

        # 11-13: 右后 (BR)
        (f"11. 右后肩 → {RB_sh} (1150-{DS},右腿收腿方向)",     f'1 {RB_sh}',   None),
        (f"12. 右后小腿 → {RB_shin} (1600-{DS},右腿收腿方向)",   f'0 {RB_shin}', None),
        ("13. 回 STAND (右后测试完)",                      'stand',     None),

        # 14-17: 左前 全收测试
        (f"14. 左前肩 收 {DS}",                              f'4 {LF_sh}',   None),
        (f"15. 左前小腿 收 {DS}",                            f'5 {LF_shin}', None),
        ("16. 回 STAND (左前全收测试完)",                   'stand',     None),

        # 17-19: 右前 全收
        (f"17. 右前肩 收 {DS}",                              f'3 {RF_sh}',   None),
        (f"18. 右前小腿 收 {DS}",                            f'2 {RF_shin}', None),
        ("19. 回 STAND (右前全收测试完)",                   'stand',     None),

        # 20-22: 左后 全收
        (f"20. 左后肩 收 {DS}",                              f'6 {LB_sh}',   None),
        (f"21. 左后小腿 收 {DS}",                            f'7 {LB_shin}', None),
        ("22. 回 STAND (左后全收测试完)",                   'stand',     None),

        # 23-25: 右后 全收
        (f"23. 右后肩 收 {DS}",                              f'1 {RB_sh}',   None),
        (f"24. 右后小腿 收 {DS}",                            f'0 {RB_shin}', None),
        ("25. 回 STAND (右后全收测试完)",                   'stand',     None),

        # 26-29: 完整踏步测试(用 STM32 固件 H_LIFT,与脚本参数无关)
        ("26. step trot (启动踏步,STM32 固件 H_LIFT)",   'step trot', None),
        ("27. 等 5 秒 (看机器狗动作)",                     None,        5),
        ("28. step stop",                                  'step stop', None),
        ("29. 最终回 STAND",                               'stand',     None),
    ]


def print_header(steps):
    print("=" * 64, flush=True)
    print(f"8 路舵机交互式分步调试  (2026-09-12)", flush=True)
    print("=" * 64, flush=True)
    print(f"UART: {UART_DEV} @ {UART_BAUD}", flush=True)
    print(f"H_LIFT: {H_LIFT_MM} mm  (PWM 偏移: {DS_PWM:.0f} µs / 关节)", flush=True)
    print(f"背景:step trot 不动 / sit/stand 通讯 OK / 分步定位问题", flush=True)
    print(f"腿顺序:左前 → 右前 → 左后 → 右后 (每条腿:大腿 → 小腿 → 回 STAND)", flush=True)
    print("", flush=True)

    # 打印 SERVO 表
    print("8 路舵机表(中文名):", flush=True)
    print(f"  {'id':<3} {'中文名':<18} {'STAND':<6} {'方向':<8} {'收腿 PWM':<10} {'limit':<12}", flush=True)
    for s in SERVOS:
        id, name, stand, is_right, smin, smax = s
        dir_str = "右腿(PWM-)" if is_right else "左腿(PWM+)"
        lp = lift_pwm(id)
        print(f"  {id:<3} {name:<18} {stand:<6} {dir_str:<10} {lp:<10} ({smin},{smax})", flush=True)
    print("", flush=True)

    # 打印步骤列表
    print(f"预设步骤 ({len(steps)} 步):", flush=True)
    for i, (desc, cmd, sleep_s) in enumerate(steps):
        extra = f" sleep={sleep_s}s" if sleep_s else ""
        cmd_str = f"'{cmd}'" if cmd else "(仅 sleep)"
        print(f"  [{i:>2}] {desc}  → {cmd_str}{extra}", flush=True)
    print("", flush=True)


def main():
    steps = make_steps()
    print_header(steps)

    # 开串口
    try:
        ser = serial.Serial(UART_DEV, UART_BAUD, timeout=0.3)
    except Exception as e:
        print(f"[ERR] 串口打开失败: {e}", flush=True)
        sys.exit(1)
    time.sleep(0.3)
    ser.reset_input_buffer()
    print(f"[test] ✅ 串口已开\n", flush=True)

    cur = 0
    try:
        while True:
            if cur >= len(steps):
                print("\n[test] 所有步骤走完,退出", flush=True)
                break

            desc, cmd, sleep_s = steps[cur]
            prompt = (
                f"\n[{cur:>2}/{len(steps)-1}] {desc}\n"
                f"预命令: {cmd if cmd else '(无)'}, sleep: {sleep_s if sleep_s else 0}s\n"
                f"> [enter] 执行+跳步 | [数字] 跳步 | [文本] 自定义命令(不跳) | [q] 退出: "
            )
            try:
                inp = input(prompt).strip()
            except EOFError:
                print("\n[test] EOF,退出", flush=True)
                break

            if inp.lower() == 'q':
                print("[test] 用户退出", flush=True)
                break

            # 跳步
            if inp.isdigit():
                n = int(inp)
                if 0 <= n < len(steps):
                    cur = n
                    continue
                else:
                    print(f"  [warn] 步骤超出范围 0..{len(steps)-1}", flush=True)
                    continue

            # 自定义命令(覆盖预命令)
            if inp:
                cmd = inp
                sleep_s = None
                tag = "[自定义]"
            else:
                tag = "[预命令]"

            # 执行
            if cmd:
                try:
                    ser.write((cmd + "\n").encode())
                    ser.flush()
                    print(f"  {tag} → UART: '{cmd}'", flush=True)
                except Exception as e:
                    print(f"  [ERR] 串口写失败: {e}", flush=True)
                    break

            if sleep_s:
                print(f"  → sleep {sleep_s}s ...", flush=True)
                time.sleep(sleep_s)

            # enter(空)才跳步,自定义命令不跳步(可重复测)
            if not inp:
                cur += 1

    except KeyboardInterrupt:
        print("\n[test] Ctrl+C 中断", flush=True)

    finally:
        # 回 STAND
        print("\n[test] 回 STAND 收尾...", flush=True)
        try:
            ser.write(b"stand\n")
            ser.flush()
            time.sleep(0.3)
        except Exception:
            pass
        ser.close()
        print("[test] 串口已关, done", flush=True)


if __name__ == "__main__":
    main()
