xiaolongsya/x3-stm32-robot-dog/(commit log)

2026-09-10 8 路舵机标定 + 加 UART 接收 Pi 命令接口
    - 8 个舵机都标定完成(中位 Pulse=1500, 90° → 大腿水平 + 小腿垂直)
    - main.c 加 UART 命令解析(set_servo_pulse + uart_poll)
    - 命令协议: '<servo_id 0-7> <pulse 500-2500>\n' / 'all <pulse>\n' / 'center\n'
    - STM32 回 OK s<N>=<pulse> / OK all=<pulse> / OK center / ERR fmt
    - 加 STM32CubeIDE 工程文件 .cproject / .project 入仓(打开工程用)
    - 8 路舵机映射表(main.c set_servo_pulse):
    0=PA2=TIM2_CH3 / 1=PA3=TIM2_CH4 / 2=PA4=TIM3_CH2 / 3=PA5=TIM2_CH1
    4=PA6=TIM3_CH1 / 5=PA7=TIM17_CH1 / 6=PB0=TIM3_CH3 / 7=PA8=TIM1_CH1
    接 Pi 通信: Pi GPIO14(TXD) → PA10(RX) / Pi GPIO15(RXD) → PA9(TX) / GND-GND
    后续: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
2026-09-10 标定完成进度同步 + 新增运动学参数文档
    README.md:更新到 2026-09-09(标定完成、固件详情、移植待办)
    运动学参数.md:v0.1 初稿,记录小腿舵机几何参数 + 远场近似模型 + 蹲下起立动作设计初稿
2026-09-10 新增 Pi 端舵机 UART 控制脚本 servo_uart.py (pyserial + /dev/ttyS1 115200 8N1)
2026-09-10 运动学参数 v0.2:8 路舵机映射 + 默认姿态 + L_link=60
    - 舵机映射确认:对称分布(前后肩/小腿 + 左右镜像)
    - 前肩:servo3(FR)、servo4(FL);前小腿:servo2(FR)、servo5(FL)
    - 后肩:servo1(BR)、servo6(BL);后小腿:servo0(BR)、servo7(BL)
    - 默认姿态:大腿垂直地面 + 小腿水平向前(X+ 方向)
    - 坐标系:X 向前(头朝向)、Y 向左、Z 向上
    - 几何新增 L_link = 60 mm + 初始连接杆方位(ΔX=18mm, ΔY≈0, ΔZ≈57.24mm)
    - 第 5.5 节新增严格四连杆求解说明(L_link 较短,远场近似误差大,需 Newton 迭代)
    - 用户期望默认姿态"站起来一点":目标身体高度待定
2026-09-10 运动学参数:补测项细化到 X/Y/Z 三分量 + u_s/u_k 含义图示
    - §2.3 d_servo_hip 拆为 X/Y/Z 三分量,补 u_s / u_k 含义说明(单位向量)
    - §7.2 同步更新 TODO 列表
    - 加 ASCII 草图引导用户目视回答舵机偏心点 + 小腿偏心点的初始方向
2026-09-10 运动学参数 v0.3:几何约束明确为 2D(X-Z 平面)
    用户描述舵机几何后,旋转方向和偏心平面已确定:
    - 肩部舵机:转轴 = 大腿方向(±Z),偏心点在水平 X-Y 平面内
    - 小腿舵机:转轴 = 垂直小腿方向(±Y),偏心点在 X-Z 平面内
    降维成果:
    - d_servo_hip.Y 理论为 0,无需测(从 ΔY=0 + u_s/u_k 都无 Y 分量推出)
    - 求解从 3D 降为 2D,旋转统一绕 Y 轴
    - 待测参数从 5 个减为 3 个(d_servo_hip.X/Z + α_s + α_k),任答 2 个可反推第 3 个
    §2.3 / §5.5 / §7.2 同步更新。
2026-09-10 运动学参数 v0.4:α_s 部分已知(A=12.09°),待测参数减为 2 个
    用户描述小腿舵机初始几何:
    - 舵盘和传动杆连接点离舵机中心 x 距离 = 10.5 mm
    - sin A = 10.5 / R_servo = 0.2095 → A = 12.09°(偏心方向与竖直方向夹角)
    - X 分量 = +10.5 mm 已知,Z 分量符号待确认(偏上/偏下)
    d_servo_hip 可从已知几何(ΔX=18, ΔZ=57.24)反推,无需用户测量。
    待测参数从 3 个减为 2 个:
    1. α_s 的 Z 分量符号
    2. α_k(小腿偏心点初始方向角,X-Z 平面内象限)
2026-09-10 v1 进展:STM32 身高控制 + Pi 串口打通
    STM32 端 main.c:
    - 加 apply_height_delta() 函数,4 路小腿舵机同步(servo0/2/5/7)
    - 新 UART 命令 'h <delta_mm>',例: 'h 15' -> 抬升 15 mm
    - 远场近似: 1 mm 身体抬升 ≈ 4 µs PWM 增量(HEIGHT_US_PER_MM,待实测校准)
    - 安全范围: ΔH ∈ [-40, +40] mm, PWM ∈ [500, 2500] µs
    - 保留旧命令 (id, all, center)
    Pi 端串口:
    - /boot/armbianEnv.txt: console=both -> console=display, 移除 overlays=uart5
    - 停 serial-getty@ttyS0.service
    - /dev/ttyS0 现在可被 STM32 独占使用(115200 8N1)
    - pyserial 3.5 已装(系统包)
    - /root/test_stm32_serial.py 测试脚本就绪
    运动学参数.md 同步到 v0.6,记录 STM32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
2026-09-10 fix(stm32):printf 重定向到 USART1(修回执丢失 bug)
    之前 main.c 的 printf('OK center' 等)走 SWO/ITM,不通过 USART1 TX(PA9)发送,
    所以 Pi 端 /dev/ttyS1 收不到任何回执。
    在 usart.c 的 USER CODE BEGIN 1 加 fputc 重定向,所有 printf 输出经 USART1。
    [usart.c]
2026-09-10 fix(stm32):parse 分支顺序 + GPIO 上拉 + printf 短超时(3 个 bug)
    Agent 2 排查发现的 3 个 bug:
    1. parse_uart_command 分支顺序错误:
    - 原 sscanf('%u %u') 遇到 'all' 失败但不消耗输入,导致 'all 1500' 走 else 全失败
    - 修复:用 strncmp('all ', 4) 和 cmd[0]=='h' 前置判别
    - 加 ERR fmt 回显便于调试
    2. USART1 GPIO RX 上拉:
    - 原 Pull = GPIO_NOPULL,RX idle 可能浮空,噪声误触发
    - 修复:GPIO_PULLUP
    3. printf 短超时避免死锁:
    - 原 HAL_MAX_DELAY,TX 短路会无限等,卡住主循环接收
    - 修复:5ms 短超时
    [main.c, usart.c]
2026-09-10 fix(stm32):PA10 RX GPIO 模式 AF_PP -> AF_INPUT(致命 bug)
    症状: 不接 STM32 能看到 Pi TX 数据,接上 STM32 就看不到。
    原因: PA10(RX)被 CubeMX 默认配成 GPIO_MODE_AF_PP(推挽输出),
    STM32 主动驱动 PA10 电平,直接'吃掉'Pi TX 的信号。
    修复:
    - PA9 (TX): 保留 AF_PP(推挽输出,需要驱动信号线)
    - PA10 (RX): 改为 AF_INPUT + GPIO_PULLUP(输入模式,内部上拉防浮空)
    之前所有 PA9+PA10 一起配 AF_PP,导致 RX 引脚输出反向电平,
    Pi 的串口信号被 STM32 短路掉。
    这是端到端通信失败的根因之一。
    [usart.c]
2026-09-10 fix(stm32):GPIO_MODE_AF_INPUT -> GPIO_MODE_INPUT(编译错误)
    STM32G4 HAL 没有 GPIO_MODE_AF_INPUT 枚举值,
    RX 引脚应该用 GPIO_MODE_INPUT + Alternate 复用。
    [usart.c]
2026-09-10 fix(stm32):main() 启动后强制重配 PA10 = INPUT + PULLUP
    CubeMX/HAL 可能内部动 PA10 模式,强制在 main 启动后
    再次设为 INPUT 模式(并保留 Pull-up),覆盖任何错误配置。
    [main.c]
2026-09-10 fix(stm32):回归 CubeMX 标准 + 修 10ms 轮询丢字节 bug(Agent 1 报告采纳)
    Agent 1 多 agent 排查后的真根因 + 正确修法:
    1. GPIO_MODE_INPUT 是错的(我之前判断 AF_PP 让 STM32 拉低 RX 是错的):
    - HAL_GPIO_Init 在 INPUT 模式不写 AFRH,AF 没设上,USART1_RX 根本没连 PA10
    - 改回 CubeMX 标准 GPIO_MODE_AF_PP,这个本来就对
    - AF 模式下 RX 引脚不会被外设主动驱动
    2. 真根因: 10ms 轮询 + timeout=0 + FIFO 关闭
    - RDR 只存 1 字节,7 字节命令 0.6ms 全到,后 6 字节溢出
    - ORE 置位但因 timeout=0 不清,永远拼不出 \n
    - 修复: 取消 HAL_Delay(10),主循环尽可能快轮询
    3. main.c 里那段 force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
    [main.c, usart.c]
2026-09-10 feat(stm32):默认 PWM 1500 -> 1530(微抬升 ~7.5mm,验证烧录用)
    - SERVO_NEUTRAL_US 改 1530
    - 上电初始化 8 路 PWM 改 1530
    - center 命令回 SERVO_NEUTRAL_US(1530)而不是硬编码 1500
    用户调试用:上电时身体自动微抬升,验证新代码是否真烧进去。
    正常使用时改回 1500(标定基线)即可。
2026-09-10 feat(stm32):默认 PWM 1530 -> 1580(默认站起来一点 ~20 mm)
    用户要求'再高一点,默认站起来一点'。
    - SERVO_NEUTRAL_US: 1530 -> 1580
    - 上电 8 路初始化 PWM: 1530 -> 1580
    - 身体从标定基线抬升 ~20 mm(1mm = 4µs 远场近似)
    后续调整:不满意可改 SERVO_NEUTRAL_US 改其他值。
2026-09-10 feat(stm32):默认姿态站起来一点(身体+大腿前倾)
    用户要求'默认站起来一点' + '大腿顺时针转一点':
    - SERVO_NEUTRAL_US: 1640(小腿抬升 ~35 mm)
    - 上电初始化分两路:
    * 4 路大腿舵机(servo1/3/4/6)= 1530 µs(顺时针前倾 +30 µs ~ +2.7°)
    * 4 路小腿舵机(servo0/2/5/7)= 1640 µs(身体抬升 ~35 mm)
    = 综合效果:小狗上电即'站起来一点'
2026-09-10 feat(stm32):默认姿态站起来再加大(身体 +50mm,大腿 +9°)
    用户反馈之前动得太小,这次加大:
    - SERVO_NEUTRAL_US: 1640 -> 1700(身体抬升 ~50 mm)
    - 大腿 4 路: 1530 -> 1600(顺时针 +9°)
    - 小腿 4 路: 1640 -> 1700(身体抬升 ~50 mm)
    = 综合:小狗上电即'明显站起来'
2026-09-10 fix(stm32):默认姿态方向修正 + 小腿加大
    用户实测反馈:
    - 大腿 +PWM(1600)实际是逆时针让身体变矮
    - 小腿 1640 -> 1700 变化小,要加大
    修正:
    - SERVO_NEUTRAL_US: 1700 -> 1850(身体抬升 ~85 mm)
    - 大腿 4 路: 1600 -> 1400(-100 µs,~ -9° 反方向前摆,弯曲腿让身体高)
    - 小腿 4 路: 1700 -> 1850(+350 µs,身体抬升 ~85 mm)
    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
    [main.c]
2026-09-10 fix(stm32):左腿(servo4/5/6/7)PWM 反向(3000 - pwm)
    用户实测反馈:'站起来了,但左边两个小腿和大腿都反了'。
    左腿舵机(servo4 FL 肩, servo5 FL 小腿, servo6 BL 肩, servo7 BL 小腿)在标定时反向,
    所以 PWM 输出要取反(3000 - 期望 pwm):
    - 大腿左腿:1400(右腿)-> 1600(左腿,3000-1400)
    - 小腿左腿:1850(右腿)-> 1150(左腿,3000-1850)
    = 4 路左腿 + 4 路右腿 = 8 路 PWM 协调
    [main.c]
2026-09-10 fix(stm32):前后腿不对称(前腿降,后腿升)防后仰
    用户实测反馈:'站不住,后仰,后面两只脚幅度应该大一点'。
    修复:形成前低后高,平衡身体,防后仰:
    - 前腿小腿(FR/FL):1850 -> 1800(右)/1200(左反向)=-50 µs ~ -12.5 mm
    - 后腿小腿(BR/BL):1850 -> 1950(右)/1050(左反向)=+50 µs ~ +12.5 mm
    - = 后腿比前腿高 ~25 mm,身体前倾平衡
    [main.c]
2026-09-11 refactor(stm32):回到标定基线 1500,8 路舵机都设 1500
    用户要求'对 8 个舵机重新标定'。
    - 上电初始化:8 路舵机 PWM = 1500(标定基线)
    - SERVO_NEUTRAL_US: 1850 -> 1500
    - 删掉所有非标定的 PWM 偏移(前腿 1800/1950、左腿反向等)
    = 进入'重新标定模式':
    1. CubeIDE Clean + Build + 烧录
    2. STM32 上电:8 路舵机都到 1500 µs(标定基线)
    3. 用户手动把每个舵机臂装到 90 度几何居中位置
    4. 装上机械结构,后续身高命令(h delta)以 1500 为基线
2026-09-11 feat(stm32):标定后默认站立姿态(右腿顺时针,左腿逆时针)
    用户标定完成后给出旋转方向(从舵机后方看):
    - 右腿小腿/肩:顺时针 = PWM 减小(1400)
    - 左腿小腿/肩:逆时针 = PWM 增大(1600)
    = 4 路右腿 PWM 1400(-100),4 路左腿 PWM 1600(+100)
    = 左右镜像,小狗'站起来一点'
    注意:之前'标定后用 1500 居中'的版本已废,这个 commit 替代。
2026-09-11 feat(stm32):前低后高姿态(后腿幅度更大,4 路小腿都抬)
    用户最新要求:'前膝盖离地对的(前腿弯曲贴地 OK), 高度不够,
    前后都要提高, 后大腿要更大变化, 4 路小腿都提高, 后小腿多提高'
    设计:
    前腿(servo2/3/4/5):肩 -100/+100,小腿 -200/+200
    后腿(servo0/1/6/7):肩 -200/+200,小腿 -300/+300
    = 综合:后腿比前腿弯得更多、抬得更高
    = 效果:身体高、前低后高(防后仰)
2026-09-11 fix(stm32):后腿大幅弯 + 修代码损坏(Python脚本误删前缀)
    1. 修复 Python 脚本误删 __HAL_TIM_SET_COMPARE 前缀的 4 行
    2. 用户反馈'站不起来,小腿太平了,前后都一样',重新设计:
    - 前腿:肩 ±100,小腿 −50/+50(前腿不弯太多)
    - 后腿:肩 ±200,小腿 −200/+200(后腿大幅弯抬)
    新 PWM:
    - servo0 BR 小腿: 1300(-200,后腿大)
    - servo1 BR 肩: 1300(-200,后腿大)
    - servo2 FR 小腿: 1450(-50,前腿小)
    - servo3 FR 肩: 1400(-100)
    - servo4 FL 肩: 1600(+100)
    - servo5 FL 小腿: 1550(+50,前腿小)
    - servo6 BL 肩: 1700(+200,后腿大)
    - servo7 BL 小腿: 1700(+200,后腿大)
    [main.c]
2026-09-11 refactor(stm32):8 路舵机默认 PWM 提到顶部全局常量(默认 1500)
    用户调试用:直接在 main.c 顶部修改这 8 个常量,烧录后生效:
    - SERVO_SHOULDER_BR / FR / FL / BL = 1500(肩部)
    - SERVO_SHIN_BR / FR / FL / BL = 1500(小腿)
    当前状态:全部 1500(标定基线)。
    用户可按反馈方向:
    - 右腿顺时针 = PWM 减小(< 1500)
    - 左腿逆时针 = PWM 增大(> 1500)
2026-09-11 feat(stm32):站立/蹲下姿态 + sit/stand UART 命令(2026-09-11)
    站立/蹲下姿态通过顶部宏切换:
    - SERVO_*_STAND(用户实测微调,身体高、4 脚同步落地)
    - SERVO_*_SIT(算法:站立 ±100 朝中,腿伸直+少弯曲)
    新 UART 命令:
    - stand → 切到站立姿态(1200/1300/1620/1750/1600/1600/1400/1400)
    - sit → 切到蹲下姿态(1300/1400/1520/1650/1500/1500/1500/1500)
    上电默认站立。
2026-09-11 fix(stm32):PA10 改回 GPIO_MODE_AF_PP(关键修复)
    多 agent 排查最终根因:
    - 之前改的 GPIO_MODE_INPUT 让 HAL_GPIO_Init 跳过了 AFR 配置
    - 导致 USART1_RX 没路由到 PA10 引脚
    - RXNE 永远不置位 → STM32 完全收不到 Pi 命令
    改回标准 AF_PP:
    - HAL 正确写 AFR[AF7] = USART1_RX
    - AF_PP 在 RX 方向(USART 没数据发时)只走输入路径
    - 不会主动拉低 PA10(OE 由 USART 控制,空闲时 0)
    [usart.c]
2026-09-11 refactor(stm32):清理 STM32 代码(删 sit 蹲下 + 身高控制)
    理由:蹲下起立对平衡性和舵机能力要求较高,偶尔卡死起不来,
    有风险先放弃。身高控制 h <delta_mm> 依赖 sit,一并删除。
    改动:
    - main.c:删 SERVO_*_SIT 常量(8 个)+ apply_height_delta/set_all_shin_pwm
    函数 + UART sit/h 命令分支;保留 SERVO_NEUTRAL_US(标定基线,center 用)
    - README.md:更新 STM32 Firmware 状态 + 已弃用条目
    - 运动学参数.md:§6/§9 改为已弃用说明,§11 里程碑同步
    恢复:git log 找 feat(stm32):站立/蹲下姿态(2026-09-11),
    回滚 main.c 即可。
    下一步:基于 py-apple-dynamics PA_GAIT.trot(x_target=0) 移植踏步动作。
2026-09-11 feat(stm32):gait.c/h PA_GAIT + IK 移植骨架 + 标定辅助 + step trot
    移植范围:
    - PA_GAIT.trot 对角小跑步态(x_target=0 即原地踏步)
    - PA_IK.ik case=0 串联腿反运动学(余弦定理)
    - PA_ATTITUDE.cal_ges 简化版(仅 PIT=ROL=X=0)
    - 舵机输出公式按 padog.servo_output case=0 + stand_pwm 反推 init 角度
    新增文件:
    - Core/Inc/gait.h:接口(gait_init/start_trot/stop/tick + 标定辅助)
    - Core/Src/gait.c:~400 行移植实现
    main.c 改动:
    - 加 current_pwm[8] 跟踪 set_servo_pulse 调用
    - 加 UART 命令: cal raw / cal save / cal show / step trot / step stop
    - stand 命令改用 stand_pwm 数组(运行时可标定覆盖)
    - 上电默认用 gait_get_stand_pwm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
2026-09-11 docs:更新 README.md(标定模式 + 踏步骨架状态) + 修正 CLAUDE.md 标定原理
    - README.md:STM32 Firmware 状态行更新;新增标定/步态 UART 命令描述;踏步骨架状态
    - CLAUDE.md:修正'大腿水平+小腿垂直'为'大腿垂直+小腿水平'(2026-09-11 用户明确)
2026-09-11 fix(stm32):编译错误修复(export 常量/函数 + htim6 条件编译)
    修复内容(20 个错误):
    - main.h: export SERVO_*_STAND / SERVO_NEUTRAL_US 常量 + set_servo_pulse 原型
    让 gait.c 可见
    - main.c: 删本地 SERVO_*_STAND 宏(已移到 main.h);set_servo_pulse 改非 static
    - gait.h: 加标定辅助函数声明(gait_cal_raw/save_stand_array/show_stand/get_stand_pwm)
    - gait.c: HAL_TIM_Base_Start_IT / Stop_IT 用 #ifdef HAL_TIM6_MODULE_ENABLED 包裹
    没配 TIM6 时直接打印错误,不引用未定义的 htim6
    编译命令:CubeMX 未加 TIM6 时,gait_start_trot 打印
    'ERR gait: TIM6 not configured, please add TIM6 in CubeMX...'
    加 TIM6 后(HAL_TIM6_MODULE_ENABLED 自动定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
    [main.c, main.h]
2026-09-11 fix(stm32):cal raw 直接调 __HAL_TIM_SET_COMPARE(1500) 8 路(绕过 set_servo_pulse)
    用户反馈:cal raw 后体态没变,怀疑 set_servo_pulse/gait_cal_raw 函数链路有问题。
    改成 main.c 里直接 8 个 __HAL_TIM_SET_COMPARE(1500),与上电初始化 HAL_TIM_PWM_Start
    后的默认写法保持一致,确保舵机真的收到 1500。
    同时同步 current_pwm[i]=1500,避免后续 cal save 时保存旧 STAND 偏移。
    [main.c]
2026-09-11 refactor(stm32):main.h STAND 参数重排为按腿分组(FL/FR/BL/BR)+ 中文标注
    按用户要求(2026-09-11)改写 Exported constants 区块:
    - 按 4 条腿分组(前左 FL/前右 FR/后左 BL/后右 BR)
    - 每路加中文标签(左前肩/左前小腿/右后肩 等)
    - 注释标 PWM 方向对姿态影响(↑身体高/↓身体低)
    - 命名规则说明在顶部
    索引 servo_id 0-7 不变(gait.c / main.c 仍然按 servo_id 走)。
2026-09-11 fix(stm32):main.c main 函数缺 1 个 } + main.h 加回 set_servo_pulse 原型
    [main.c, main.h]
2026-09-11 fix(stm32):TIM6_DAC_IRQHandler 调 gait_tick + it.c include gait.h + set_servo_pulse 原型移 USER CODE 区外
    [main.h]
2026-09-11 fix(stm32):STAND 参数修正版(2026-09-11 用户实测 4 脚都承重)
    修正后的站立参数(用户实测,手动抬 4 腿都抬不动,确认承重):
    - 左前肩 FL 肩: 1620 → 1820(+200,腿伸)
    - 左前小腿 FL 小腿: 1400 → 1500(+100,腿伸直)
    - 右前肩 FR 肩: 1300 → 1200(-100,腿伸)
    - 右前小腿 FR 小腿: 1600 → 1500(-100,腿收)
    - 左后肩 BL 肩: 1750 → 1850(+100,腿伸)
    - 左后小腿 BL 小腿: 1400(不变)
    - 右后肩 BR 肩: 1200 → 1150(-50,腿伸)
    - 右后小腿 BR 小腿: 1600(不变)
    范围 1150~1850(±350µs 偏离 1500 中位),说明舵机机械零位(1500)与
    机械站立位有偏移,需要 ±350µs 才能让 4 脚同时承重(机械公差大)。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
    [main.h]
2026-09-11 refactor(stm32):废弃旧 gait.c + 新 stepping.c/h 移植 py-apple-dynamics V7.3
    设计变更:
    - 删除旧 gait.c/h + cal raw/save/show + step trot/stop + current_pwm 跟踪
    - 新增 stepping.c/h 移植 py-apple-dynamics V7.3 SRC:
    * PA_GAIT.trot 对角小跑步步调度(原地踏步,x_target=0)
    * padog.swing_curve_generate + support_curve_generate 摆/支撑相足端轨迹
    * PA_IK.ik case=0 余弦定理串联腿反解
    * PA_ATTITUDE.cal_ges 简化版(仅 PIT=ROL=X=0 → 传 -Hc 偏移)
    - 自研 servo_output(不套 py-apple 的 init_*=90° + ±90 偏移):
    * init_* 直接从 SERVO_*_STAND 实测反推
    * 镜像通过 ham/shank 符号翻转(腿1/4 vs 腿2/3)
    * ham_std 前腿 96.7°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
2026-09-11 fix(stm32):shin 公式符号翻转 + SERVO_LIMIT 改单向范围
    问题:
    - 上一版 FR/BR shin 抬腿时 PWM 增加(超出 STAND 上限)
    - FL/BL shin 抬腿时 PWM 减少(超出 STAND 下限)
    - 用户实测:STAND 是小腿'最高位'极限,只能往一个方向动
    - shin 公式翻转符号:FR/BR 用 -, FL/BL 用 +(与 thigh 相反)
    - thigh 公式保持不变:FR/BR 用 +, FL/BL 用 -(远离 1500 = 更平行)
    - SERVO_LIMIT 改为单向范围:
    * shin: STAND ±150µs(10mm 抬腿需 ~137µs,留余量)
    - FL 1500-1650 / FR 1350-1500 / BL 1400-1550 / BR 1450-1600
    * thigh: STAND ±200µs(用户拍板起步保守,三四百也行)
    - FL 1820-2020 / FR 1000-1200 / BL 1850-2050 / BR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
2026-09-11 feat(stm32):加 sit 命令(8 路回 1500,腿完全伸直/居中)
    用户要求:'加一个蹲下的动作回到1500,然后默认还是站立,通信来改变姿势是蹲下还是站立'。
    - 上电默认: 站立(SERVO_*_STAND 常量,不变)
    - stand 命令: 应用 STAND 数组
    - sit 命令: 8 路全设 1500(腿完全伸直,新加)
    通讯协议:
    - 收到 'stand' -> 狗子站立
    - 收到 'sit' -> 狗子蹲下(腿伸直)
    - 其他命令保留: center / h / cal / etc.
2026-09-11 fix(stm32):printf 5ms 改回 HAL_MAX_DELAY
    用户实测:端到端通,但 Pi 端 no reply。改了 printf 超时。
    [usart.c]
2026-09-11 fix(stm32):printf 重定向补全 __io_putchar(之前 fputc 漏了)
    - usart.c 之前只实现 fputc,没实现 __io_putchar
    - ARM GCC newlib 的 printf 走 syscalls.c::_write → __io_putchar(weak)
    - 之前 __io_putchar 没 override,_write 实际上调到了 weak 默认,printf 输出被吞
    - Pi 端 readline 永远等不到 \n,回包空字符串
    - test_stand_sit.py'可运行'是假象:它用 in_waiting 检查,没数据就 (no reply),不报错
    用户误以为正常,实际 STM32 一直不回
    - 在 usart.c 同一个 USER CODE 区加 __io_putchar(同 fputc 实现)
    - HAL_MAX_DELAY 同 fputc(避免短超时丢字符)
    影响:
    - 此修复前所有 main.c/parse_uart_command 的 prin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
    [usart.c]
2026-09-11 refactor:清理废弃 + 修踏步 TIM6 bug + README 与代码对齐
    【固件修复】
    - stepping.c: 去掉 #ifdef HAL_TIM6_MODULE_ENABLED(全工程未定义),无条件启动 TIM6
    - 之前 step trot 永远走 #else 分支直接返回,这是踏步从没跑过的根因
    【README 修订(7 处与代码/CLAUDE.md 对齐)】
    - 舵机引脚:PB3 → PA8(实际是 TIM1_CH1)
    - 电池监控:PA8 ADC → PA0 ADC
    - 几何描述:大腿水平+小腿垂直 → 大腿垂直地面+小腿水平向前(用户实测)
    - 步态参数:抬腿 15mm/100ms → 抬腿 10mm/1s(实际 stepping.c STEP_H_LIFT=10、STEP_T_INC=0.01)
    - 删 cal raw/save/show、stand_pwm 数组描述(代码已删)
    - 网表文件名:Netlist_控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
    [kws_realtime_oww.py, kws_train_oww.py, kws_voice_control.py, slice_wav.py]
2026-09-11 docs(固件):统一 STAND/方向约定 + SERVO_LIMIT 改对称范围(2026-09-12)
    【方向约定(用户多轮拍板,2026-09-12 立)】
    - 1500 = 舵机中位 = 大腿垂直 + 小腿水平(几何最高)
    - STAND = 4 脚贴地的实测姿态,作为步态参考基线,非机械端点
    - 肩部任意方向转都会降低身体高度,只为平衡需要把大腿折开
    - 小腿决定身体升降:伸展=升高,内折=降低
    - 左右舵机反装,左/右腿 PWM 方向相反,物理动作方向一致
    【PWM 方向】
    | 舵机 | PWM 增 → | PWM 减 → |
    | 左小腿(5/7) | 内折 | 极限伸展 |
    | 右小腿(0/2) | 极限伸展 | 内折 |
    | 左肩(4/6) | 外展 | 内折 |
    | 右肩(1/3) | 内折(右舵机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
2026-09-12 docs(固件):PWM 方向表修正(2026-09-12 用户拍板)
    【修正前后差异】
    - 旧:左右舵机反装,左/右 PWM 方向相反
    - 新:左右小腿 PWM 方向相反(反装)+ 前后肩 PWM 方向相反(初始几何)
    【新规则】
    - 所有肩部'折'物理方向一致(大腿往中线靠拢)
    - 所有小腿'伸展'物理方向一致(升高身体)
    - 8 路 STAND 全部满足:4 肩内折 + 4 小腿极限伸展
    【main.h 加完整对照表】
    - id=0/1/2/3/4/5/6/7 每路 STAND + PWM 增/减对应物理动作
    - 备查用,不参与代码
    [main.h]
2026-09-12 docs(固件):PWM 方向表改用'后/前旋转'定义(2026-09-12)
    【用户最新定义】
    - 内折 = 大腿往小狗后侧(X-)旋转(对 4 肩成立)
    - 小腿往后旋转 = 站得更高(对 4 小腿成立)
    - '往后旋转'物理方向在 4 路舵机上统一
    【左/右舵机反装规律】
    - 右舵机:P 减 = 往后转(肩=平衡 / 小腿=升)
    - 左舵机:P 增 = 往后转(肩=平衡 / 小腿=升)
    【对照表】
    - 8 路舵机每路标注 P 增/P 减对应物理动作
    - 4 肩 STAND = 平衡姿态(4 肩不同方向,符合左右反装)
    - 4 小腿 STAND = 极限伸展(后转极限)
    【memory 同步更新】
    - machine-dog-v1-mechanical.md 改用'后/前旋转'描述
2026-09-12 refactor(stepping):抛弃 PA-apple IK,改用远场近似 + 收腿模型 (2026-09-12)
    - 完全抛弃 PA-apple IK + py-apple swing 曲线
    - 抬腿 = 收腿 = 右腿 PWM 减 + 左腿 PWM 增
    - 抬腿曲线:sin²(π × phase/0.5),边界连续无跳变
    - ISR 内不 printf(修 MEDIUM 风险,避免阻塞 UART,与 Pi no-reply 同源)
    参数(2026-09-12 用户拍板):
    - H_LIFT = 5 mm
    - T = 2.0 s (T_INC=0.005)
    - PWM_PER_MM = 4 (远场近似 1mm ≈ 4µs)
    8 路 PWM 全程在 SERVO_LIMIT 内:
    - 启动 phase=0 自动 STAND 无跳变(sin²(0)=0)
    - BR 小腿 swing [1580,1600],余量 180µs 单边
    - BL 小腿 swing [1400,1420],余量 180µs 单边
    - FR/FL 小腿 swing ±20µs,余量 80µs(余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
2026-09-12 fix(stepping):去掉 stepping_*() printf,防阻塞 main loop 卡死 UART 接收 (2026-09-12)
    应对 Pi no-reply bug 的连带风险:
    - 即使 STM32 printf 卡死在 HAL_MAX_DELAY,TIM6 ISR 仍按 100Hz 跑
    - 但 main loop 阻塞导致用户无法发 step stop 停止
    - 只能断电重启
    去掉 stepping_start_trot / stepping_stop / stepping_show 的 printf:
    - stepping_show 变空函数(接口保留,main.c 不需改)
    - 去掉 <stdio.h> include(不再用)
    - 失去调试回执(暂时)
    - 消除 printf 阻塞 main loop 阻断 step stop 的风险
    恢复方式:修 usart.c __io_putchar 改短 timeout 后,放开 stepping_show 的 printf 即可。
    Refs: machine-dog-v1-pose-gait memory, machine-dog-v1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
2026-09-12 test(scripts):加 test_trot_5s.py — Pi 端跑 N 秒踏步测试 (2026-09-12)
    用法:python3 scripts/test_trot_5s.py [seconds]
    默认 5 秒。
    - 开 /dev/ttyS1 @ 115200
    - 发 'step trot', 进度条显示剩余时间
    - N 秒后发 'step stop'
    - 不依赖 STM32 printf 回执(no-reply bug)
    - timeout 由 ssh 调用方控制
    已知问题诊断(2026-09-12 第一次跑没动):
    - STM32 可能没烧最新固件(需 commit 753e686 或更新)
    - Pi↔STM32 UART 接线需核对(Pi GPIO14/15 ↔ STM32 PA10/PA9 + GND 共接)
    - 调试时建议用 USB 转串口直连电脑看 STM32 是否回执
    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
    [test_trot_5s.py]
2026-09-12 test(scripts):加 step_debug.py — 8 路舵机交互式分步调试 (2026-09-12)
    用法:python3 step_debug.py
    背景:step trot 不动,但 sit/stand 通讯 OK,需要分步定位问题。
    - 列 SERVO 表 + 30 步预设(从单关节到完整踏步)
    - 交互:enter 执行预命令+跳步 / 数字跳步 / 文本自定义命令(不跳)/ q 退出
    - Ctrl+C 或 q 退出时自动回 STAND
    预设步骤分组:
    - 0-1: 起始 (all 1500 / stand)
    - 2-13: 单关节测试 (1,3 脚肩/小腿 + 2,4 脚肩/小腿)
    - 14-25: 单腿全收 (FR / BL / FL / BR 各 2 步)
    - 26-29: 完整 step trot 测试
    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
    [step_debug.py]
2026-09-12 tune(stepping):H_LIFT 5mm → 10mm,×2 调试 (2026-09-12)
    用户实测 5mm 抬腿太微弱,肉眼难辨。
    ×2 到 10mm 让动作可见。
    - FR/FL 小腿 swing 80µs 余量,10mm 摆动 40µs,余量 2× 仍安全
    - 其他舵机余量更大,完全安全
    - stepping.h 头注释同步
    需要 CubeIDE 重新烧录。
2026-09-12 test(scripts):加 pi_remote_trot.py — Pi 端 100Hz 发 8 路 PWM 模拟 trot (2026-09-12)
    目的:不让 STM32 跑 ISR(避免烧固件),改 Pi 端接管。
    用法:python3 pi_remote_trot.py [H_LIFT_mm] [SECS]
    默认 H_LIFT=10mm, SECS=5s。
    - 与 STM32 stepping.c stepping_trot_step 同样算法(sin² + 收腿)
    - 8 路 PWM 100Hz 通过 UART 发给 STM32
    - STM32 main.c 已支持 <id> <pulse> 单路命令,无需烧录
    - H_LIFT 在 Pi 端任意调
    已知限制:
    - Python 不是硬实时,max_lag 显示落后量
    - 如 lag >5ms 步态抖动,建议烧 STM32 跑 ISR
    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
2026-09-12 test(scripts):step_debug.py 加 H_LIFT 参数,Pi 端可调抬腿高度 (2026-09-12)
    让 step_debug.py 接收 H_LIFT_MM 参数(默认 10):
    - 命令行: python3 step_debug.py [H_LIFT_MM]
    - 环境变量: H_LIFT
    - 所有'收腿'步骤的 PWM 偏移 = H_LIFT × 4(远场近似)
    - STEPS 改用 make_steps() 动态生成
    之前版本所有 PWM 是硬编码的 20µs(= 5mm),STM32 不烧固件就改不了。
    现在 Pi 端调 H_LIFT 即可,不必烧 STM32。
    示例:
    - python3 step_debug.py 5 # 5mm
    - python3 step_debug.py 10 # 10mm 默认
    - python3 step_debug.py 15 # 15mm 逼近 SERVO_LIMIT
    注意:step trot 那一步(26-29)仍用 STM32 固件 H_LIFT,与脚本参数无关。
    如要 Pi 完全控制 trot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
2026-09-12 test(scripts):step_debug.py 改中文舵机名 + 步骤按腿顺序 (2026-09-12)
    用户反馈:BR/FL 缩写看不懂,步骤按对角线组织不顺。
    1. SERVOS 表舵机名改中文('右后小腿 (BR)' 等),括号保留英文缩写作对照
    2. STEPS 顺序从'对角线 (腿1+3 → 腿2+4)' 改成'按腿' (左前 → 右前 → 左后 → 右后)
    3. 每条腿:大腿 → 小腿 → 回 STAND (一条腿做完再下一条)
    4. 单腿全收测试同样按腿顺序 (左前全收 → 右前全收 → 左后全收 → 右后全收)
    其他不变:H_LIFT 参数、enter/数字/文本/q 交互、auto-回 STAND。
    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
2026-09-12 test(scripts):加 test_printf.py — 触发 STM32 printf,逻辑分析仪抓波形 (2026-09-12)
    用法:python3 test_printf.py [DEVICE] [CMD1 CMD2 ...]
    默认 DEVICE=/dev/ttyS1, COMMANDS=sit stand center all 1500 step trot step stop
    每个命令间隔 1s,给逻辑分析仪抓 STM32 PA9 波形的时间。
    配合 no-reply bug 诊断:
    - 探头 CH1 = STM32 PA9,CH2 = Pi GPIO15 (Pin 10)
    - Pi 跑这个脚本,同时看 CH1 是否有 'OK sit' 等 115200 波形
    - CH1 有 + CH2 无 → 接线错(pads 不对)
    - CH1 无 → STM32 printf 没工作
    [test_printf.py]
2026-09-12 fix(stm32):no-reply 修复 — setvbuf 禁 stdout 缓冲 + __io_putchar while 重试 (2026-09-12)
    逻辑分析仪证据(2026-09-12):
    - Pi 端 /dev/ttyS1 发 sit,STM32 PA10 收到(下行脉冲)
    - STM32 PA9 全程静默,printf('OK sit') 数据没发出
    .elf 符号表(已查):
    - __io_putchar 在 0x08001a79,size=36,GLOBAL FUNC,被正确链接
    - _write 在 0x08001097,size=56,WEAK FUNC(默认实现可能不调用我们的 __io_putchar)
    - 编译/链接没问题,bug 在运行时
    运行时修复:
    1. usart.c __io_putchar / fputc 改 while 重试,防御 gState=BUSY 时
    HAL_UART_Transmit 返回 HAL_BUSY 静默丢字符
    2. main.c MX_USART1_UART_Init 之后立刻 setvbuf(stdout, NULL, _IONBF, 0)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
    [main.c, usart.c]
2026-09-12 test(stm32):主循环每秒发 PING,逻辑分析仪持续抓 PA9 (2026-09-12)
    配合上电自检:
    - 上电发 3 条: STM32 BOOT OK / HCLK=xxx MHz / READY
    - 主循环每 1s 发 PING\n 持续输出
    逻辑分析仪一直采 PA9,STM32 一上电就能看到持续字节流。
    不需要 Pi 发命令,不依赖通讯通。
    修好后删除 main loop PING 那块。
2026-09-12 fix(stm32):PA9/PA10 GPIO_SPEED LOW → HIGH,压过 Pi PH3 内部 pull-up (2026-09-12)
    - STM32 PA9 单独测(不接 Pi):有 PING 字节
    - 插上 Pi RX (PH3):波形被拉,解码失败
    根因(Armbian commit 8510e1b 暴露):
    - sun50i-h616-orangepi-zero2.dtsi uart5_pins = PH2/PH3
    - 默认带 internal pull-up(~50kΩ)
    - STM32 PA9 GPIO_SPEED_FREQ_LOW 推挽驱动电流不足以压过 Pi 端 pull
    - 信号被拉,115200 波形变形,UART 解码失败
    修复:PA9 改 GPIO_SPEED_FREQ_HIGH,加大推挽驱动能力。
    PA10 顺便也改(RX 也用 HIGH 抗噪声)。
    需要 CubeIDE Clean Build + 重烧。验证:
    - 拔 Pi,STM32 PA9 单独测有 PING(已确认)
    - 接 Pi,逻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
    [usart.c]
2026-09-13 chore:Pi 时代脚本与模型归档 docs/legacy/(2026-09-13)
    - scripts/ 全部移到 docs/legacy/:kws/record/ctl/test 等 Pi 时代脚本
    - model/xiaolong.onnx 移到 docs/legacy/
    - 仓库 origin URL 改为 x3-stm32-robot-dog(remote 改名待用户在 GitHub 网页 Settings 操作)
    - scripts/ 现在为空目录,后续 X3 / 本地模型脚本会重新填充
2026-09-13 feat(stm32):motions 模块 + 无通信模式重构(2026-09-13)
    新增 motions.c/h(动作注册表 + 调度):
    - 编译时用 MOTION_ID 宏切动作(MOTION_STAND/MOTION_TROT/MOTION_WALK)
    - 每个动作独立 setup()/tick(),start_delay_s + duration_s 字段
    - 加新动作:在 MOTION_TABLE 末尾 append,不动 main.c
    main.c 清理:
    - 删 no-reply 调试:上电三行 printf + 每秒 PING
    - 主循环改为 motion_poll() + uart_poll()
    - 上电默认动作 = MOTION_STAND(改 MOTION_ID = MOTION_TROT 自动 10s 后踏步)
    设计动机:
    - 香橙派已出二手,旭日 X3 未到货,期间无法通过 UART 选动作
    - 改宏 + 重烧 .bin 是最简方式(符合用户决策)
    - X3 上线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
2026-09-13 docs(readme):精简 README 反映当前状态(2026-09-13)
    - Architecture 图改成 X3 2.0 占位 + 旧 Pi 注释说明已退役
    - Quick Start 加 motions.h MOTION_ID 切换说明
    - Project Status 表格同步:Pi → X3,sit 已不实现,motions 模块在
    - 删除 v0 调试细节(老 commit 节点、已弃用 sit/h 列表),链接到 git 历史
    - 删掉重复的 UART 命令详细列表(CLAUDE.md 已有 memory 索引)
    doc-only,不动代码
2026-09-13 chore:精简 .gitignore + 删 xiaolong.onnx 入库(2026-09-13)
    .gitignore 删冗余规则(113 → ~95 行):
    - 删 memory/、.ai-memory/(本就在 ~/.claude/,重复)
    - 删 data/tmp/、scratch.*、*.test、*.spec、__tests/(项目里无对应目录)
    - 删 *.tmp 重复(留 PCB 工具段那一处)
    - 删 *.tmp 段落(临时数据段归并)
    新增跟踪忽略:
    - docs/legacy/xiaolong.onnx(ONNX 模型 857KB,训练数据已足够还原)
    路径体检结果:CubeIDE 工程元数据(.cproject/.project/.mxproject)
    - 全部使用相对路径 + Eclipse 变量()
    - 无硬编码 /c/Users/17402/...
    - 新笔记本 clone 后可直接 Import 工程,无需改任何文件
2026-09-14 feat(stm32):整理固件架构 + 8路STAND标定归档 (2026-09-14)
    **8路舵机 STAND 值(2026-09-14 整理后)**
    - 6 路标准:BR/FR 小腿=1600, BR/FR 肩=1100, FL 小腿=1400, BL 肩=1900
    - 2 路机械偏置:FL 肩=2000(+100), BL 小腿=1580(+80)
    - PWM 中位 1500 = 大腿垂直 + 小腿水平
    **SERVO_STEP 安全限位(8 路按用户拍板统一)**
    - 4 小腿宽度都 = 700
    - 4 肩宽度都 = 1600
    **4 个动作(2026-09-14 整理后)**
    - STAND:写 SERVO_*_STAND 然后保持
    - TROT:写 TROT_STAND(中立位,无前倾),start_delay 后启动 stepping,保持到 stop
    - BOB:STAND ↔ SIT(1500)循环,各 5s
    - SHIN_TEST:8 路同步线性 ramp 测小腿范围
    **架构整理(2026-09-14)**
    - main.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
2026-09-15 chore(.gitignore): X3 端 KWS 训练产物 + IDE 元数据 ignore (2026-09-15)
    - X3端/kws/.venv/ Python venv(几百 MB,本地复现用)
    - X3端/kws/model_xiaolong/ 训练中间产物(npy / *_train / *_test / .pt / .onnx)
    - /project + .workflow/ Eclipse 元数据 + AI 工作流(根目录)
    - voice_data/ 规则仍生效(自动匹配 X3端/voice_data/)
2026-09-15 feat(x3): KWS 唤醒词训练管线(小龙, openWakeWord) (2026-09-15)
    X3 端 (运行 on X3.2.0):
    - record_wakeword.py 三模式录音(正样本/负样本 10词轮换/环境噪声)
    - slice_env.py 长 wav 切成 2s 片段(纯 stdlib)
    - kws_realtime_log.py 实时麦克风监听,score>=0.7 输出唤醒日志
    PC 端 (运行 on Windows/Linux):
    - train_xiaolong.py openWakeWord 训练(FCN 1536->128->128->1)
    - requirements-pc.txt torch / openwakeword / soundfile / scipy / numpy
    数据(本地保留,不入库):
    - voice_data/ 100 正 + 100 负(10词x10轮) + 150 环境噪声切片
    成果:
    - 模型 xiaolong.onnx 857KB,端到端测试 '小龙' peak 0.985
    - 部署: scp 到 X3 /home/roo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
2026-09-16 feat(stm32): X3 ↔ STM32 UART 链路打通 + HSI 168MHz + PA2/PA3→TIM15 + servo7(PA8/TIM1)恢复
    * CubeMX .ioc: TIM1_CH1=PA8 (servo7), TIM15_CH1=PA2 (servo0), TIM15_CH2=PA3 (servo1)
    * CubeMX .ioc: HSI 16MHz → PLL ×21 → 168MHz SYSCLK (替代 HSE 8MHz 路径)
    * CubeMX .ioc: USART1 = PA9/PA10 115200 8N1, DMA+IDLE 中断
    * CubeMX .ioc: TIM6 = 100Hz, TIM7 = 1kHz (stepping + watchdog)
    * main.c: MX_TIM*_Init 顺序对齐 CubeMX 配置
    * main.c: set_servo_pulse case7 → htim1 TIM_CHANNEL_1 (按 CubeMX CH1=PA8)
    * main.c: HAL_TIM_PWM_Start 加 TIM15 CH1+CH2 (servo0/servo1)
    * usart.c: fputc / __io_putchar 改用 HAL_MAX_DELAY 重试
    * tim.c: CubeMX 自动生成, 配 PA2/PA3→TIM15_CH1/CH2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
2026-09-16 feat(stm32): 新增 X3 协议模块 (commands/buzzer/watchdog/diagnostic/dma)
    * commands.c/h: USART1 DMA + IDLE 中断接收,二进制协议解析
    - 帧格式: AA 55 <len> <cmd> [data...] <csum8> (XOR-8)
    - cmd 集: 0x01 MOTION_PLAY, 0x03 SET_PWM, 0x05 HEARTBEAT,
    0x06 EMERGENCY_STOP, 0x07 BUZZER_ON, 0x08 BUZZER_OFF
    - 文本兼容模式: 'stand'/'center'/'servo_id pulse' 等 (需 mode text 切换)
    * buzzer.c/h: PA11 蜂鸣器 (有源 2.7kHz),timer tick 控制时长
    * watchdog.c/h: TIM7 1kHz,200ms 无心跳自动回 STAND
    * diagnostic.c/h: 上电发阶段标记字符 (12356BC),从 main.c 搬出
    - 解决 CubeMX Generate Code 丢 '}' bug
    * dma.c/h: DMA 配置 (USART1 RX/TX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
2026-09-16 chore(docs): X3 参考手册 + PC 端测试脚本 (2026-09-16)
    * RDK_X3_1.0_Product_Brief.pdf X3 产品手册
    * RDK_X3_2.0_IO_Schematics.pdf X3 引脚/接口原理图
    * RDK_X3_Specification.pdf X3 规格书
    * 旭日X3 40pin引脚表.png X3 40-pin 物理接口对照表
    * 测试脚本/send_binary.py PC 端 STM32 二进制协议命令脚本
    * 测试脚本/send_command.py PC 端 STM32 UART 命令脚本 (兼容文本 + 二进制)
    * 测试脚本/send_stand.py PC 端 STM32 'stand' 文本命令脚本
    用于 X3 ↔ STM32 链路联调时 PC 端交叉验证。dog_uart.py 是 X3 端正式 CLI,
    PC 端脚本只在开发期临时用(无心跳,不持久)。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
2026-09-16 feat(stm32): ramp 模块 + ACTION_PLAY 0x09 + BL 小腿校准重构 + duration_s fix (2026-09-16)
    * 新增 ramp.h/c — 8 路 PWM 同步渐进 ramp (SIT/STAND 用,主循环调 ramp_tick())
    - 起点 = 当前 PWM (set_servo_pulse 同步给 ramp.c 的 g_pwm 跟踪)
    - 线性插值, 8 路同步; clamp 到 SERVO_LIMIT 安全范围
    - 完成回调 on_ramp_complete_idle 清 current
    * 新增 commands.c ACTION_PLAY 0x09 case:
    - id 1..4 走 motion_play_by_id (既有 MOTION_PLAY 路径)
    - id 5..8 走 ramp 路径 (SIT_DOWN / STAND_UP / SIT_TO_STAND / STAND_TO_SIT)
    * motion_play_action (motions.c):
    - 任何 ramp 启动前先 stepping_stop() 防相位错位
    - SIT_RAMP_MS 默认 800ms, STAND_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
    [MachineDog_V1.ioc, main.c, main.h]
2026-09-16 feat(x3): dog_uart.py 控制 CLI + KWS 实时日志增强 (2026-09-16)
    * 新增 X3端/dog_uart.py — X3 端机器狗控制 CLI (STM32 二进制协议封装)
    - 心跳线程 100ms 一发 (保持 watchdog 不超时,姿态维持)
    - 子命令: sit / stand / squat / trot / bob / beep / seq / stop / pwm / raw
    - 串口 /dev/ttyS3 @115200 (X3 ↔ STM32)
    - ACK 自动校验 (容忍 STM32 夹发的诊断文本 'OK\n')
    - Ctrl+C 或脚本退出 → 心跳停 → 200ms 后 STM32 自动回 STAND (watchdog)
    * 新增 X3端/kws/run_kws_log.sh — '小龙' 唤醒词实时日志一键启动
    - 自动注入 PYTHONPATH (openwakeword 装在 --user,site-packages 在 /root/.local)
    - 支持阈值参数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
2026-09-16 docs(readme): 2026-09-16 重整状态 (ramp 模块 + BL 校准重构 + X3 上线)
    * v1 板子当前状态: STAND 标定改为'正站立' (BL 小腿 1580→1480, 取消 +80 偏置)
    * SERVO_STEP 表更新 BL (1480-2180) 与实际机械行程对齐
    * 固件模块清单: 新增 ramp.c/h, commands/watchdog/buzzer 已落地
    * 命令集: 0x09 ACTION_PLAY 走 ramp SIT/STAND (id 5..8)
    * X3 端工具: dog_uart.py + KWS log + run_kws_log.sh
    * 高层 MCU 状态: 从 '待到货' 改为 '已上线 (UART ↔ STM32, KWS)'
    * ramp SIT/STAND 时长: SIT_RAMP_MS=800, STAND_RAMP_MS=1200
    * 历史里程碑: 2026-09-14 X3 协议 + 2026-09-16 ramp 重构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
2026-09-16 docs: 蜂鸣器链路作废 (2026-09-16 用户拍板)
    - README.md: 协议章节 0x07-08 标记废弃,移除 sensor stack / 模块清单的 buzzer
    - 投板前审查报告: § 五引脚 / § 七工艺 / BUZ-06 条目 / § 十整章加注'硬件留 /固件不驱动'
    - BOM 库存对照: BUZZER1 标注不采购
    CLAUDE.md 已删设计表同步加一行(memory: machine-dog-v1-no-buzzer.md)
    STM32 源码(buzzer.c/h + commands.c 0x07/0x08)和 X3 dog_uart.py beep 命令等用户拍板后再处理
2026-09-16 refactor(stm32+x3): 蜂鸣器链路真删 (2026-09-16 用户拍板)
    STM32 端:
    - 删 buzzer.c/h(物理文件,CubeIDE 自动扫描 Core/Src/*.c 不需要改 .cproject)
    - commands.c:删 #include "buzzer.h" + case 0x07/0x08
    - commands.h:协议注释 0x07/0x08 标废(X3 不发,STM32 收到回 BAD_CMD(2))
    - main.c:加 pa11_silent_init() 替代 buzzer_init(),PA11(BUZZER_CTRL) 输出低保持静默
    - stm32g4xx_it.c:删 #include "buzzer.h"
    X3 端(dog_uart.py):
    - 删 CMD_BUZZER_ON/OFF 常量
    - 删 DogLink.beep() 方法
    - 删 seq "beep N" 解析
    - 删 argparse beep 子命令 + --ms/--gap
    - 删 main() beep 处理 + 用法说明
    硬件保留:R5 + Q1 SS8050 + D3 + BUZZER1 在板上不驱动(已投板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
    [dog_uart.py, main.c]
2026-09-16 feat(pc-brain): PC 端 brain 服务代码框架 (2026-09-16)
    X3 ↔ PC 语音大脑 PC 端起步。架构(已拍板):
    - WS server @ 8765 (websockets asyncio)
    - JSON 协议: X3→PC utterance(pcm base64)/ping; PC→X3 action/pong/error
    - ASR: FunASR SenseVoiceSmall (FP32, ~1.5G 显存, 首跑自动下模型)
    - LLM: Ollama qwen3:8b OpenAI 兼容 + JSON Schema 约束 + 思考关闭
    - 多轮历史: 最近 3 轮,LLM prompt 里以自然语言拼
    - 错误处理: LLM 非 JSON 重试 1 次、cmd/id 非法跳过、actions>8 截断、ASR 空不调 LLM、LLM 超时 5s 兜底
    - System Prompt 含人格设定(中文名字小龙)
    11 文件 772 行:
    - brain.py WS server 入口 + --test 单测
    - llm.py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
2026-09-16 feat(pc-brain): .gitignore PC端规则 + run/rec 脚本
    - .gitignore:加 PC端/.venv/、__pycache__/、tests/*.wav/*.mp3、*.egg-info/
    - PC端/brain/run.sh:Git Bash / WSL / Linux / macOS 一键启动
    - PC端/brain/run.ps1:Windows PowerShell 一键启动(检查 Ollama → 拉模型 → 创/激活 venv → 起 brain)
    - PC端/brain/tests/rec.sh:ffmpeg/arecord 录 16k 单声道 wav
    - PC端/brain/tests/rec.ps1:PowerShell + ffmpeg 录 wav
2026-09-16 feat(x3): KWS 唤醒 → STM32 蹲下起立 + STM32 链路诊断工具
    架构(用户拍板简化):KWS 唤醒 → 直接发 STM32 动作(跳 ASR/LLM/WS)
    - X3 端:openWakeWord xiaolong.onnx + 阈值 0.85 + 后台心跳守护
    - STM32 端:已存在的 motions.c 的 ramp SIT/STAND 动作
    关键发现:
    - STM32 motion_play_action(id, duration_ms) 中,id 5/8 = 蹲下,id 6/7 = 起立别名
    - '蹲下起立' 在 STM32 端不是单一动作,需 X3 端连发两帧:
    1) ACTION_PLAY [5,1] 蹲下(SIT_RAMP_MS=800) + 等 1.2s
    2) ACTION_PLAY [6,1] 起立(STAND_RAMP_MS=1200)
    - cooldown 提到 3.5s(蹲下 1.2s + 起立 1.6s + 缓冲)
    - STM32 watchdog 200ms 超时回 STAND,必须 100ms 一发心跳
    文件: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
2026-09-16 fix(x3): stm32_sit_test.py ACK 帧头解析(0x02 → 0x01)
    STM32 commands.c 的 ACK 帧格式:
    AA 55 [data_len] [cmd|0x80] [status] [data...] [csum]
    status 占 1 字节,无额外 data 时 data_len=1(不是 2)。
    测试脚本原找 'AA 55 02 89',实际 ACK 是 'AA 55 01 89',所以总是
    打印'没收到 ACK'。现在脚本会正确识别 ACK。
    不影响主功能 kws_with_action.py(那个用的是 send_frame 内的
    b"\xaa\x55\x01\x89" 已经是 0x01)。
    [stm32_sit_test.py]
2026-09-16 feat(pc-brain): 切 Ollama 原生 API + Modelfile + asr INT8 量化
    LLM (llm.py 重写):
    - OpenAI 兼容端点 → Ollama 原生 /api/chat (httpx)
    原因:兼容端点 think:false 不生效,Qwen3 默认 thinking 6s 延迟;
    原生 API + think:false → 0.3s 推理。
    - 默认 model 改为 'xiaolong'(基于 qwen3:8b-q8_0 + 关 thinking + 预置 system prompt)
    - 用户拍板:Ollama 模型自己掌控开/关,llm.py 默认 model 改一行即可切换
    - SYSTEM 三引号包裹(避免多行 Modelfile 解析失败)
    - 保留重试 + 超时 + JSON Schema 验证 + 兜底回复
    Modelfile (新建):
    - FROM qwen3:8b-q8_0 + 推理参数 (num_ctx/num_predict/temperature)
    - SYSTEM 三引号包裹预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
2026-09-16 feat(pc-brain): tests/rec_batch.ps1 10 条语音命令录制脚本
    覆盖场景:
    - 友好问句(01, 08)
    - 命令短句(02, 03)
    - 复合命令(04)
    - 重复动作(07)
    - STM32 没能力的指令(05, 06, 10)→ 期望 LLM 回 '我还不会'
    - 同义表达(08, 09)
    特性:
    - 按 Enter 开始录音(给你 0.5s 静默时间模拟唤醒延迟)
    - 默认 3 秒/条,可调 -Sec
    - 自动命名 01.wav ~ 10.wav 到 tests/voice_commands/
    - ffmpeg 优先(精确 16k/mono/16bit),fallback Windows MediaRecorder + Python resample
    - 录完自动列文件清单 + 给下一步命令
2026-09-16 feat(x3): X3 端 10 条语音命令录制脚本
    rec_batch.sh: 在 X3 上从 USB 麦(plughw:0,0)录制 10 条测试命令,
    arecord -d 自动停,按 Enter 开始下一条,输出到 /root/kws/test_wavs/01.wav ~ 10.wav。
    录音完 scp 回 PC(PC端/brain/tests/voice_commands/)做 ASR+LLM 端到端测试。
    注:PC端/brain/tests/rec_batch.ps1 是上一版(用本机麦),保留作为本机调试备选。
    正式场景必须用 X3 麦(生产环境一致)。
2026-09-16 test(pc-brain): 批量测试脚本 + 10 条 X3 麦录制的 wav
    batch_test.py: 跑 10 条 wav → ASR → LLM → 汇总输出
    - ASR: avg 86ms (100% 成功)
    - LLM: avg 1722ms,首次 warmup 8.6s,稳态 ~500ms
    - TOTAL: avg 1807ms(临界 2s 目标)
    测试结果:
    - 5/10 完美: 08/09 基本动作 + 05/06/10 兜底
    - 5/10 待改: 01/02/03 LLM 解析 + 04 duration 误解 + 07 repeat 序列
    voice_commands/: X3 USB 麦录的 10 条 16k mono s16_le wav(3 秒/条)
    覆盖: 友好问句 / 命令短句 / 复合 / 重复 / STM32 无能力指令 / 同义表达
2026-09-16 feat(pc-brain): few-shot prompt + temperature 0.1 (第四版)
    prompts.py 第四版: 7 个 few-shot Q→A 例子 + 简化规则
    - 用户友好问句(你可以蹲下吗?)→ [5],直接做不反问
    - 踏步3秒 → MOTION_PLAY#2 duration_ms=3000
    - 蹲下再站起来 → [5, 6]
    - 蹲下起立3次 → 6 个 actions [5,6,5,6,5,6]
    - 立正! → [EMERGENCY_STOP]
    - 摆动左腿 → [] 兑底
    - 请坐下 → [5]
    llm.py: temperature 0.3 → 0.1(更确定性输出)
    Modelfile: 同步新 prompts.py(858 chars) + temperature 0.1
    - ollama rm xiaolong && ollama create -f Modelfile
    实测(2026-09-16):
    - ASR avg 72ms max 288ms (100% 成功)
    - LLM avg ~500ms (稳定)
    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
2026-09-16 feat(asr): ASR 后处理(数字归一 + 同义词纠正)
    ASR 输出常见问题:
    - 数字 '3' 听成 '三','5' 听成 '五'(中文 ASR 默认行为)
    - 字面误识:'立正'→'李正', '起立'→'其立'
    - 标点被吞('立正!'→'立正')
    后处理:
    1. normalize_cn_numbers(): '三'→'3', '五'→'5', '七'→'7' 等
    - 跳过'一/两'(量词概率高:一下/一个/一点)
    - 支持 0-99 中文数字('十三'→13, '二十三'→23)
    2. correct_common_errors(): '李正'→'立正', '其立'→'起立', '尊下'→'蹲下'
    3. postprocess_asr_text() 主入口, transcribe() 末尾调用
    测试结果(v3 JSON):
    - 10/10 完美(只剩标点/语气词'吧/把'差异,不影响 LLM 解析)
    -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
2026-09-16 feat(brain): 改进 PC 端日志,显示 ASR 转写 + LLM actions + 分段耗时
    旧日志: 'ASR: ...' + 'total 1500ms: 1 actions, reply=...'
    - 只显示 actions 数量,不知道具体动作
    - 没分段耗时
    新日志:
    [ws=N] ASR 86ms: '你好好可以蹲下吗'
    [ws=N] LLM 500ms: actions=[ACTION_PLAY#5] reply='好的'
    [ws=N] total 608ms (asr=86 + llm=500)
    调试 PC brain 服务时一目了然(知道 ASR 转写、LLM 解析的 actions、每段耗时)。
    方便 X3 KWS 接续录音链路集成时验证。
2026-09-16 fix(x3): KWS 回声自触 — busy 状态 + cooldown 10s
    问题: 用户唤醒一次后,KWS 持续监听到回声/机械声 → 无限重复触发唤醒。
    1. cooldown 3.5s → 10s(回声衰减时间)
    2. 加 'busy' 状态机:录音 + WS 上传 + STM32 执行期间,KWS 完全屏蔽
    3. main loop: 录音完毕 → set_busy(True) → upload → 发动作 → sleep 冷却剩余 → set_busy(False)
    状态机:
    - 'kws': KWS 监听中
    - 'recording': VAD 录音中(刚唤醒)
    - 'busy': WS + STM32 执行中(屏蔽 KWS,防回声)
    修复后:唤醒一次 → 完整链路 → 等 cooldown → 才允许下一次唤醒。
    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
    [kws_record_send.py]
2026-09-16 fix(x3): 误唤醒 (ASR_FAIL) → cooldown ×3
    问题: cooldown 期满后,KWS 又检测到 score 0.97+ (回声),
    触发新一轮录音,但录音里只有背景噪声(没用户说话)。
    修复: ASR 失败(ASR_FAIL) 视为'误唤醒',cooldown ×3(10s → 30s)。
    这样连环误唤醒会被快速拉到 30s 级别,真正用户说话能正常打断。
    判断逻辑:
    - actions 不空:正常唤醒,cooldown 默认
    - actions 空:用户说了话但能力外(不当误唤醒)
    - ASR_FAIL:录音里没声音 = 误唤醒 =cooldown ×3
    - 无响应:WS 断开,按 ASR_FAIL 处理
    [kws_record_send.py]
2026-09-16 fix(x3): RMS 预筛 + cooldown 累加(根因修复)
    根因: 用户已分析对,KWS 持续高分不是 cooldown 问题,是
    狗动机械声被麦拾取 → KWS 误识为'小龙'。之前加的 cooldown/busy
    都是治标。
    1. RMS 预筛: KWS 评分前先看帧能量
    - rms < 100: 纯静音/没人说话,跳过
    - rms > 3500: 狗机械声/拍桌/噪声,跳过
    - 100 < rms < 3500: 人说话区间,才 KWS 评分
    2. Cooldown 累加: 连续误唤醒 → effective cooldown 倍增
    - 1 次: base (10s)
    - 2 次: ×3 = 30s
    - 3+ 次: ×5 = 50s
    - 封顶 60s
    3. 成功唤醒 → 重置误唤醒计数
    双重保护:
    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
    [kws_record_send.py]
2026-09-16 fix(x3): 错把 self 当 link 用(主循环变量名错误)
    Bug: 在 run() 函数里 self 不存在(只有 link),
    原代码 'self.consecutive_false_wakes = 0' 报 NameError
    导致第一次唤醒后 + 完成链路 → finally 块崩溃。
    修复: 全部 self → link
    [kws_record_send.py]
2026-09-16 fix(x3): _finish_recording race condition — mode 设 busy 不是 kws
    Bug: 主循环流水线有窗口期
    _finish_recording 设 mode='kws' → return pcm
    → 主循环还没调到 set_busy(True)
    → 录音期间累积在 queue 里的 chunk(可能含 dog 动机械声)
    → process_chunk 看到 mode='kws' → 评分 → 高分 → 唤醒!
    这就是为什么 cooldown 期满后'立刻'又唤醒
    因为 race 窗口里的 chunk 触发了 KWS。
    修复: _finish_recording 直接设 mode='busy'
    主循环拿到 pcm 时 mode 已经是 busy
    后续 chunk 在 process_chunk 看到 busy 直接 return None
    副作用: 主循环 set_busy(True) 是幂等的(还是设 busy)
    set_busy(False)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
    [kws_record_send.py]
2026-09-16 fix(x3): 真根因 — 清空 cooldown 期内累积的 queue 陈旧 chunk
    用户测试证明: 纯 KWS 脚本 kws_realtime_log.py 完全正常
    平时 score 0.010, 说'小龙' 0.97+, 之后沉默。
    所以不是 KWS 模型 / 环境 / 狗机械声问题。
    真根因: kws_record_send.py 主循环里
    录音 + WS + cooldown (共 ~12s) 期间
    arecord 持续往 queue put 80ms chunk
    → queue 累积 100+ 旧 chunk
    cooldown 期满 set_busy(False) → mode='kws'
    → 下一轮 queue.get() 拿到录音后期的旧 chunk
    → process_chunk 看到 mode='kws' → RMS 区间 + cooldown 期满 → 评分
    → 狗动机械声/回声 score 0.97+ → 触发唤醒
    修复: set_busy(False) 之前清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
    [kws_record_send.py]
2026-09-16 refactor(x3): cooldown 默认改 0(busy + queue drain 已保证间隔)
    用户逻辑: 任务完成前不能唤醒
    busy 状态屏蔽 KWS 评分(WS 上传 + STM32 执行期间)
    + set_busy(False) 之前清空 queue 累积
    = 保证'说完一句话'/'做动作'期间不可能再次唤醒
    cooldown 是冗余的双保险。
    默认 10s + ×3 累加意味着用户必须等 10+ 秒才能再说一次话
    → UX 差。
    删了之后: 任务完成(dog 蹲/起立完) → 立即可再次唤醒
    → 流畅对话
    cooldown 仍保留作为参数,可手动调大(默认 0)
2026-09-16 fix(x3): 恢复 cooldown = 3s(我之前删错了)
    错误判断回顾:
    我以为 busy + queue drain 已保证间隔 → cooldown 冗余 → 删了
    用户实测: '刚刚有冷却的时候不会这样子'
    清空 queue 后 KWS 仍持续 score 0.95+
    → 拾取了某种持续高分信号(可能是用户自己说梦话 / 麦底噪 / PC 端系统声泄漏)
    → 没有 cooldown → 连环触发
    cooldown 是必需的。改回 3s(平衡点):
    - 太短(<2s) 仍连环误触
    - 太长(>5s) UX 差
    - 3s + 累加(×3, ×5, 封顶 60s) 是最优
    [kws_record_send.py]
2026-09-16 tune(x3): cooldown 3s → 5s(用户实测 3s 仍触发一次)
    用户观察: cooldown=3s 时'一次小龙唤醒两次'(3s 太短,清空 queue
    后 KWS 立即又拾取到持续高分信号)。
    cooldown=5s 应该拦掉连二次触发。
    cooldown 累加逻辑保留(误唤醒 ×3 → ×5,封顶 60s)。
2026-09-16 fix(x3): 录音 < 2s 视为误唤醒 + 跳过动作(防连环)
    错误判断: 我之前以为'actions=空 = 不当误唤醒'
    → 错!actions 空可能是 LLM 默认回复(用户没说话)
    用户观察: '理论不需要这么长间隔'
    → 5s cooldown 后 KWS 又触发,说明第二次唤醒是误触发
    → 录音 1.52s = VAD 静音阈值(MAX_SILENCE_CHUNKS=18 × 80ms = 1.44s,余 0.08s)
    → 1.52s 是'静音提前结束',不是用户说完
    - 录音时长 < 2.0s → 视为误唤醒(false_wake = True)
    - 误唤醒 + actions 不空也不发 STM32(可能是噪声误触发)
    - 误唤醒 → cooldown ×3 累加
    正常唤醒用户说话至少 2-3s,太短就是 KWS 误触发了
    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
    [kws_record_send.py]
2026-09-16 refactor(x3): 简化 cooldown = 固定 5s(任务完成后)
    用户拍板: 任务完成后冷却 5s,固定,无累加逻辑。
    之前的 consecutive_false_wakes + multiplier 累加逻辑
    是猜测的复杂化(基于对 wav 测试的误判)。
    现在保留:
    - cooldown 固定 5s(任务完成后)
    - queue 清空(防陈旧 chunk 触发)
    - _finish_recording race 修复(mode=busy 而非 kws)
    - self→link typo 修复
    移除:
    - MAX_COOLDOWN 常量
    - consecutive_false_wakes 计数器
    - multiplier 累加逻辑
    - false_wake 标记(录音<2s 误唤醒跳过动作)
    - 录音 < 2s 跳过 STM32 动作(也移除)
    [kws_record_send.py]
2026-09-16 tune(x3): cooldown 5s → 10s(用户实测仍连环触发)
    5s 不够,用户拍板改 10s。冷却期内 KWS 评分函数 return None,
    所以 10s 不会让 dog 动不了,只是两次唤醒间隔变长。
2026-09-16 fix(x3): KWS 二次触发根因 — set_busy(False) 前 reset oww stateful buffer (喂 6s 静音)
    [kws_record_send.py]
2026-09-16 fix(x3): finally 强制 cooldown sleep 完整配置值,不被 ASR+LLM 耗时吃掉
    [kws_record_send.py]
2026-09-16 refactor(x3): KWS 双进程 — 拆出 kws_protocol.py(IPC 协议 + 常量 + PCM 编解码)
2026-09-16 refactor(x3): KWS 双进程 — 拆出 kws_listener.py(常驻 KWS + ring buffer + VAD)+ start_kws_dual.sh
2026-09-16 refactor(x3): KWS 双进程 — 拆出 kws_worker.py(独占 STM32 + WS brain + 翻译 actions,复用 dog_uart.DogLink)
2026-09-16 chore(x3): 标 kws_record_send.py 为 deprecated(双进程架构 fallback, 不删除)
2026-09-16 docs(x3): README 追加双进程 KWS 运行时架构章节(替代单进程 kws_record_send.py)
2026-09-16 fix(x3): worker import dog_uart 加 _bootstrap 找上级目录(部署在 /root/kws,但 dog_uart.py 在 /root/)
    [kws_worker.py]
2026-09-16 fix(x3): listener oww.predict() 返回值可能是 float 或 ndarray,加 isinstance 检查(与 kws_record_send.py 一致)
    [kws_listener.py]
2026-09-16 fix(x3): kws_protocol encode_pcm 重命名为 encode_pcm_b64(与 listener/worker 引用一致)
    [kws_protocol.py]
2026-09-16 fix(x3): 二次触发根因(架构已对, listener 状态机还有缝)— recording 持续喂 oww + cooldown 从录音结束算起 + ring.clear
    [kws_listener.py]
2026-09-16 feat(x3): brain prompts ASR 噪声例子 + schema maxItems 16 + 测试脚本与结果归档
    - prompts.py SYSTEM_PROMPT 追加 ASR 噪声解析规则(3秒/三秒、立正/李正、起立/其立)
    - 同步示例 Q&A 包含噪声变体
    - schema.py ACTION_SCHEMA.actions.maxItems 8 → 16(允许更多串行动作)
    - 归档 asr_results*.json / batch_v3.json + asr_only.py / summarize.py
2026-09-16 chore(x3): 走 PC brain 后清理废弃 KWS 脚本 + 修 IPC 协议字段名
    走 PC brain 路线后,以下脚本不再需要:
    - kws_with_action.py + start_kws_action.sh(简化版 KWS→STM32,不接 brain)
    - kws_realtime_log.py + run_kws_log.sh(纯监听不做事)
    协议一致性修复:
    - kws_protocol.py docstring + msg_wake() 函数体里的 type 字段
    从 "wake" 改为 "wake_detected",与 kws_listener.py 实际发送一致
    - 函数重命名 msg_wake → msg_wake_detected(grep 确认无外部调用)
    - X3/kws/README.md 回退脚本指引从 start_kws_action.sh
    改为直接跑 kws_record_send.py(后者标 deprecated 但保留作 fallback)
    [kws_protocol.py]
2026-09-16 docs: README 加 PC brain 章节 + 三层架构图 + 协议表 + 状态对齐
    链路打通 (2026-09-16) 后重整项目根 README:
    1. Architecture 图改 3 层 (PC + X3 + STM32),原图只有 X3 + STM32
    2. 新增 🧠 链路与协议 章节 (在 Documentation 后,Quick Start 前):
    - 完整链路 ASCII 图
    - 每跳数据格式表 (7 跳: 麦→X3→IPC→WS→PC→WS→X3→UART→STM32→PWM)
    - KWS 唤醒词 "小龙" 配置
    - STM32 二进制协议表 (含废弃的 0x07/0x08)
    - 端到端性能目标 (ASR < 500ms / LLM < 1.5s / 总 < 2s)
    - 启动顺序 (PC brain + X3 双进程)
    3. Project Status 表格加 X3 (KWS+翻译) + PC 大脑 + 端到端链路 三行
    4. v1 当前状态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
2026-09-16 fix(x3): rec_batch.sh scp 提示去掉硬编码 X3 IP(用户用热点 IP 会变)
    原 echo 提示硬编码 192.168.160.112,用户热点切换后 IP 经常变,
    照搬会 scp 失败。
    改为:
    1. 先在 X3 跑 `ip a show wlan0 | awk '/inet /{print $2}' | cut -d/ -f1` 查 IP
    2. 用 X3_IP 变量带进 scp 命令
    memory 已同步(X3 IP 段加 ⚠️ 不稳定注释 + 查询命令)。
2026-09-16 fix(stm32): motion_play_by_id 入口加 ramp_cancel(修 H1/H2/H6 三个高严重 bug)
    根因:motion_play_by_id() 切动作时没调 ramp_cancel(),如果之前有 SIT/STAND
    渐进还在跑,ramp_tick() 会立刻把目标 PWM 覆盖回新动作的姿态
    影响 3 条路径一次修干净:
    - H1: EMERGENCY_STOP (commands.c 走 motion_play_by_id(1,0)) — STAND 被 ramp 覆盖
    - H2: 任意 MOTION_PLAY 切动作(STAND/TROT/BOB) — 目标姿态被 ramp 覆盖
    - H6: WATCHDOG 超时回 STAND (watchdog.c 走 motion_play_by_id(1,0)) — 同 H1
    修复:在 stepping_stop() 后加 ramp_cancel(),ramp_cancel 只翻 flag 不动舵机,
    新动作的 setup() 会立刻写 8 路覆盖 ramp 残留,所以不丢控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
2026-09-16 fix(x3): kws_worker 修 3 个 bug — H3/H4 紧急动作 + busy 抢占,M3 多 ramp 等待
    H3: 紧急动作绕过 false_wake 旁路
    根因:用户短促说'停!'或'立正!'可能 < 2s,被 false_wake 旁路静默丢弃
    修复:handle_recording_done 拆 urgent(EMERGENCY_STOP)/ normal 两路
    urgent 无视 false_wake 立即执行,normal 仍受 false_wake 保护
    H4: busy 状态拒绝第二条 recording_done
    根因:用户连说两句话时,前一句的 actions 还没发完 STM32,
    第二条 recording_done 触发新的 handle_recording_done,
    asyncio.run 把前一个 event loop 中断,actions 后半段丢失
    修复:busy 时直接 drop + continue,提前 state='busy' 占位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
    [kws_worker.py]
2026-09-16 fix(stm32): 接线 TIM7 watchdog callback(修 H5 链路假通)
    根因:TIM7 Base_IT 启了,但原代码 TIM7_IRQHandler 只调 HAL_TIM_IRQHandler,
    HAL 默认通过 __weak HAL_TIM_PeriodElapsedCallback 回调,
    用户代码未 override → watchdog_poll() 从未执行,
    200ms 无心跳回 STAND 的逻辑是死代码,链路'假通'
    修复:override HAL_TIM_PeriodElapsedCallback,按 htim 路由:
    - TIM7 (1kHz): watchdog_poll() ← 补缺失的入口
    - TIM6 (100Hz): stepping_tick 已由 TIM6_DAC_IRQHandler 显式调,这里不重复
    加 if (htim->Instance == TIM6) 分支作为未来防御
    附:H6 watchdog 超时强切 STAND 走 motion_play_by_id(1,0),
    B1 已加 ramp_can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
2026-09-16 docs: 统一机械术语 —'收腿'改为'小腿向狗头方向倾斜'
    术语订正(PWM 值不变,仅注释/文档):
    - '抬腿本质 = 收腿' → '抬腿本质 = 小腿向狗头方向倾斜(脚从地面腾空)'
    - '大腿后旋 + 小腿后旋' → '大腿不动(保持 STAND),只小腿动'
    - '1500 = 几何最高' → '1500 = 大腿垂直 + 小腿平行地面(直角,部件极值位)'
    - '左右舵机镜像' → '左右舵机反装镜像(机械装配决定 PWM 方向相反)'
    范围:README.md / main.h / stepping.h / motions.c / stepping.c
    顺带补回 stepping.h 尾部换行(上一版被编辑器吃掉)
    背景:为后续步态方向(前进/后退)设计统一术语前提 ——
    旧说法'收腿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
2026-09-16 docs: 方向规则标准化 — 用户拍板"唯一判定标准" + 跪下基准
    - main.h: 方向约定重写为用户 2026-09-16 拍板的两条规律
    (同侧肩/小腿方向相反 + 左右同部位方向相反),删除旧的
    "小腿往后旋转 = 身体升高"描述
    - main.h: 补"标准值 = 跪下姿态"(6 路 1500,FL 肩 1600,BL 小腿 1580)
    - 运动学参数.md: 4.1 更正为"1500 = 跪下"(此前误作"站得更高")
    - 运动学参数.md: 4.3 补 8 路方向规则表 + 跪下→STAND 全部向后
    - stepping.c: 剩余"收腿"术语 → "向狗头方向倾斜"
    范围:main.h / 运动学参数.md / stepping.c
    背景:WALK 前进后退步态设计的前提(方向定义统一)
2026-09-16 fix: ACTION_PLAY duration_ms 完整打通(修 M4/M5/L1)
    问题(修前):ACTION_PLAY 的 duration_ms 从 PC schema 到 STM32 全链路被丢弃
    - schema.py validate_actions 不解析该字段(直接丢)
    - dog_uart DogLink.action() 形参 dur_ms 从未使用,固定发 2 字节
    - commands.c 写死传 motion_play_action(action_id, 0)
    => LLM 发"蹲下3秒"和"蹲下"效果完全一样
    新语义:ACTION_PLAY 的 duration_ms 改名 hold_ms
    - hold_ms = 0 → ramp 完成后保持终点姿态,不回 STAND(现状行为)
    - hold_ms > 0 → ramp 完成后保持 hold_ms,再渐进回 STAND
    - ramp 本身时长固定(SIT 800ms / STAND 1200ms),不受 hold_ms 影响
    协议改动(向后兼容):
    - data: [action_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
    [dog_uart.py, kws_worker.py]
2026-09-16 fix: 收尾 4 项 — 心跳锁 / cmd 重试 / 日志降噪 / 失败可见(修 M1/M2/L2/L3)
    M1 心跳线程与主线程共用 serial,write 无锁
    - 根因:pyserial 的 write 不保证原子,心跳帧(5B)与动作帧(7~10B)几乎同时写
    会让 STM32 看到错位帧头 → CRC_ERR(概率低但真实存在)
    - 修复:DogLink 加 self._tx_lock,所有 ser.write 走锁(心跳线程 + send_raw)
    - 注意:锁只保护"写",read_ack 不在锁内,否则心跳会被动作的 0.5s 等待卡住
    M2 cmd() 超时无重试、返回值被调用方忽略
    - 根因:X3 短暂丢 ACK 时动作静默丢失;EMERGENCY_STOP 丢了狗不会停
    - 修复:cmd() 加 retries=1(默认重试一次)。对现有命令安全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
    [dog_uart.py, kws_worker.py]
2026-09-16 fix(stm32): 机械物理偏移全局化 — FL肩 +100 / BL小腿 +80 在任何姿态都生效
    背景(2026-09-17 用户拍板):
    FL 肩 +100 与 BL 小腿 +80 是**物理装配偏移,永远存在**,与姿态无关。
    用一组数值验算证实了这一点(existing STAND 常量里早已烘焙,只是没人说破):
    BL 肩 1900(无偏移) vs FL 肩 2000 = 1900+100 ✓
    FL 小腿 1400(无偏移) vs BL 小腿 1480 = 1400+80 ✓
    也就是说:凡是要"回到标准位"的地方,这两路必须给 X+偏移,不能一律给 X。
    修前的问题:多处用"扁平 1500",漏了偏移
    - motions.c apply_sit_neutral():8 路全 1500
    → 上电安全起点 / motion_play_by_id 切动作过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
    [main.c, main.h]
2026-09-16 fix(stm32): TROT swing 基准统一为 TROT_STAND — 消除相位边界 100µs 台阶
    根因(stepping.c 的 stepping_trot_step):
    swing 腿的基准是 SERVO_STEP[id].stand(STAND 值)
    support 腿的基准是 trot_stand_pwm[id](TROT 中立值)
    两者不相等,而三角波在相位边界归零 →
    每次 swing↔support 切换都是 |STAND − TROT_STAND| 的硬台阶
    实测台阶(用 Python 复刻算法算 phase→0.5⁻/0.5⁺ 的极限):
    修前:BR 小腿 1500→1600 = +100µs ⚠️
    BL 小腿 1480→1580 = +100µs ⚠️
    其余 6 路 = 0
    修后:8 路全部 = 0
    影响:BR/BL 小腿每个相位边界(每踏一步两次)被硬拽 100µs
    ≈ 25mm 等效传动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
2026-09-23 修复 X3 唤醒后录音被 busy 状态丢弃
    [kws_worker.py]
2026-09-23 新增机器狗前进后退步态及语音控制链路
2026-09-23 修复前进后退慢速步态及支撑腿推进轨迹
2026-09-23 新增单腿小腿离地诊断脚本
2026-09-23 修复慢速步态支撑腿乱动及相位跳变
2026-09-23 新增两段式步态手扶测试脚本
