xiaolongsya/x3-stm32-robot-dog/(notices)

Notices in the files:
STM32项目/MachineDog_V1/Core/Src/usart.c:
Copyright (c) 2026 STMicroelectronics.
All rights reserved.
This software is licensed under terms that can be found in the LICENSE file
README.md:
License: MIT
